Kelimon/EntwklSchRob/3D Modelle/Twisted_Hexagon_Chess_Set_680373/images/Twisted_Chess_Set_Render.JPG

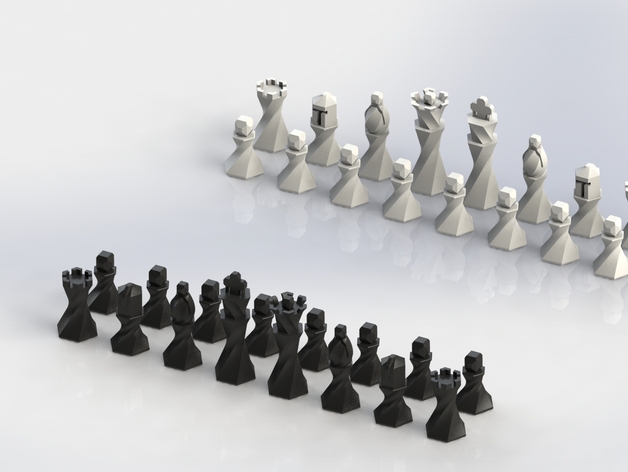
3D Modelle/Twisted_Hexagon_Chess_Set_680373/images/Twisted_Chess_Set_Render.JPG
