Kelimon/EntwklSchRob/3D Modelle/Twisted_Hexagon_Chess_Set_680373/images/Twisted_Pawn.jpg

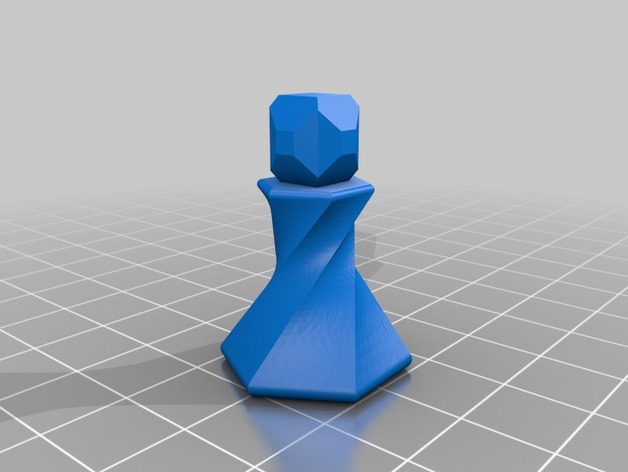
3D Modelle/Twisted_Hexagon_Chess_Set_680373/images/Twisted_Pawn.jpg
