Kelimon/EntwklSchRob/Protokolle Treffen/Notizen 28.02.2024.docx

Treffen mit Noe

Starke Zweifel an der Genauigkeit der Figurenerkennung.

Spielzug Erkennung mit Knopf.

Plausibilitätstest.

Was am meisten verändert hat.

Andere Projekte anschauen!!!!! (vor allem Du Pana)

Softwarearchitektur und Design betrachten!!!!!!!!

Nur noch 2,5 Monate!!!!!

Arbeit an Ihn schicken

25. März 10:00 Termin mit Noe und Pana zur Kamera Erkennung.

9. April 9:00 Termin mit Noe, Pana und Linus (Normaler Termin)
