Kelimon/EntwklSchRob/3D Modelle/Linearmotor Produkt Blatt.png

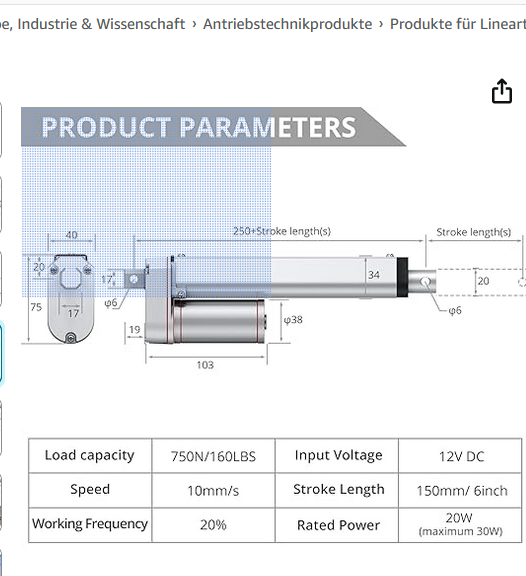
3D Modelle/Linearmotor Produkt Blatt.png
