Kelimon/EntwklSchRob/3D Modelle/Twisted_Hexagon_Chess_Set_680373/images/20150208_164236.jpg

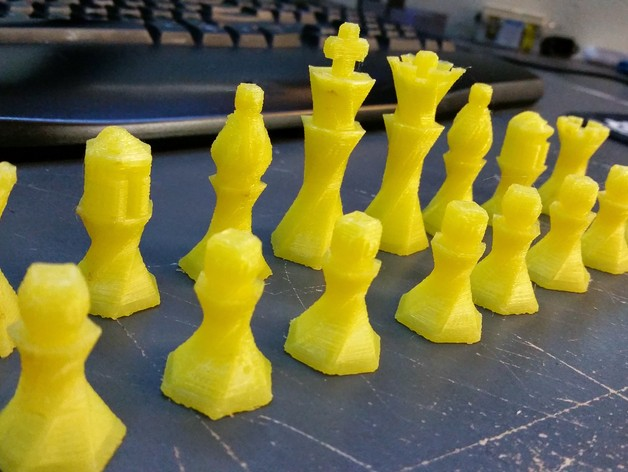
3D Modelle/Twisted_Hexagon_Chess_Set_680373/images/20150208_164236.jpg
