Kelimon/EntwklSchRob/3D Modelle/Twisted_Hexagon_Chess_Set_680373/images/20150803_194950.jpg

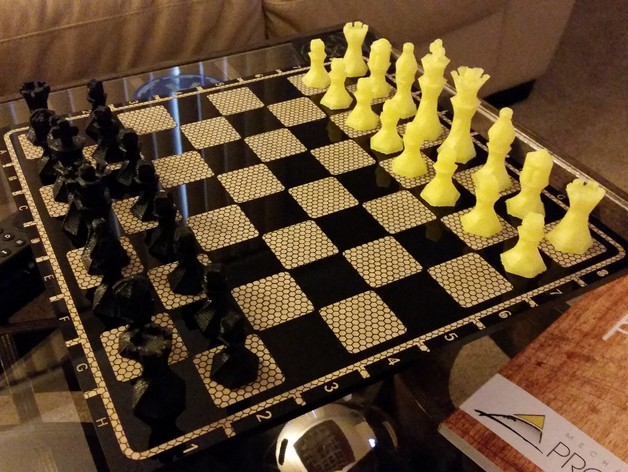
3D Modelle/Twisted_Hexagon_Chess_Set_680373/images/20150803_194950.jpg
