Kelimon/EntwklSchRob/3D Modelle/Twisted_Hexagon_Chess_Set_680373/images/Hexagon_Chess_Set_DraftSight_screen_shot.JPG

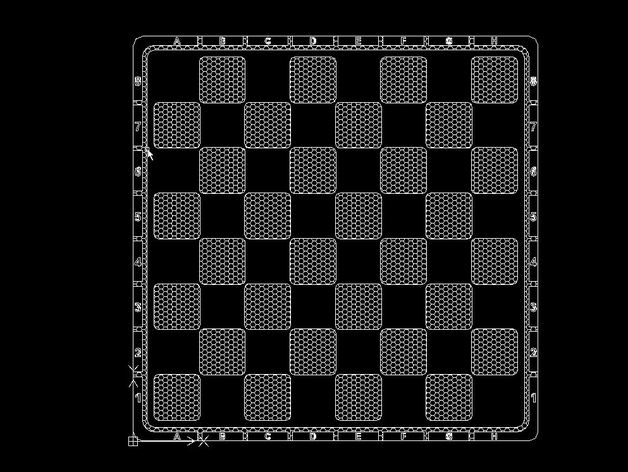
3D Modelle/Twisted_Hexagon_Chess_Set_680373/images/Hexagon_Chess_Set_DraftSight_screen_shot.JPG
