Kelimon/EntwklSchRob/3D Modelle/Twisted_Hexagon_Chess_Set_680373/images/Twisted_Chess_set_Render_-_close_up.JPG

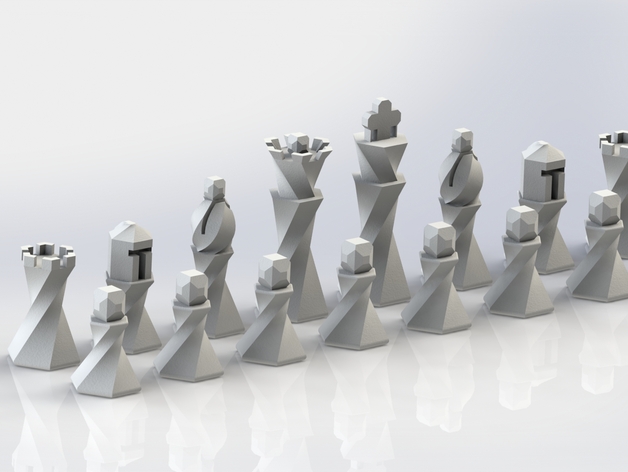
3D Modelle/Twisted_Hexagon_Chess_Set_680373/images/Twisted_Chess_set_Render_-_close_up.JPG
