Kelimon/EntwklSchRob/Bilder Studienarbeit/Bild Drehmechanismus.jpg

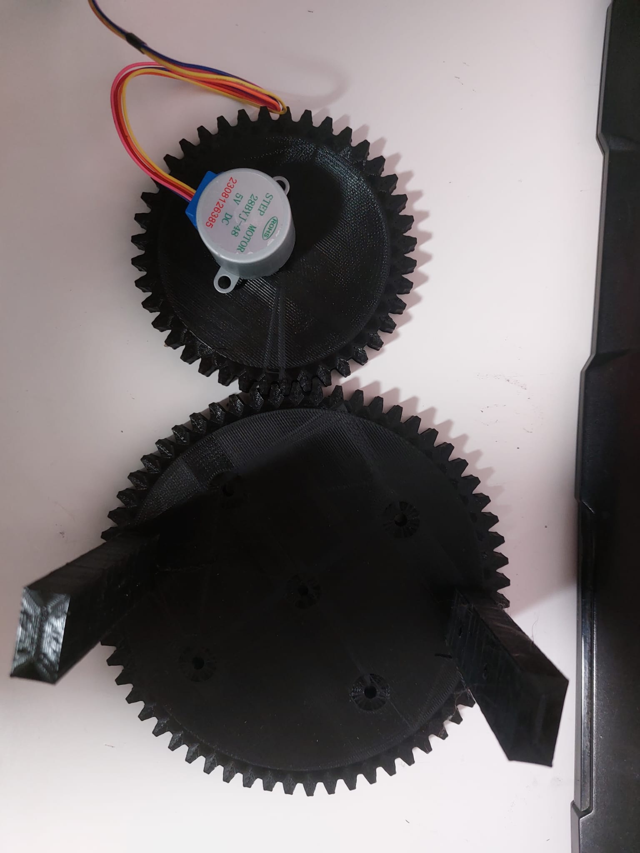
Bilder Studienarbeit/Bild Drehmechanismus.jpg
