Kelimon/EntwklSchRob/Bilder Studienarbeit/Bild Roboterarm mit Markierung.png

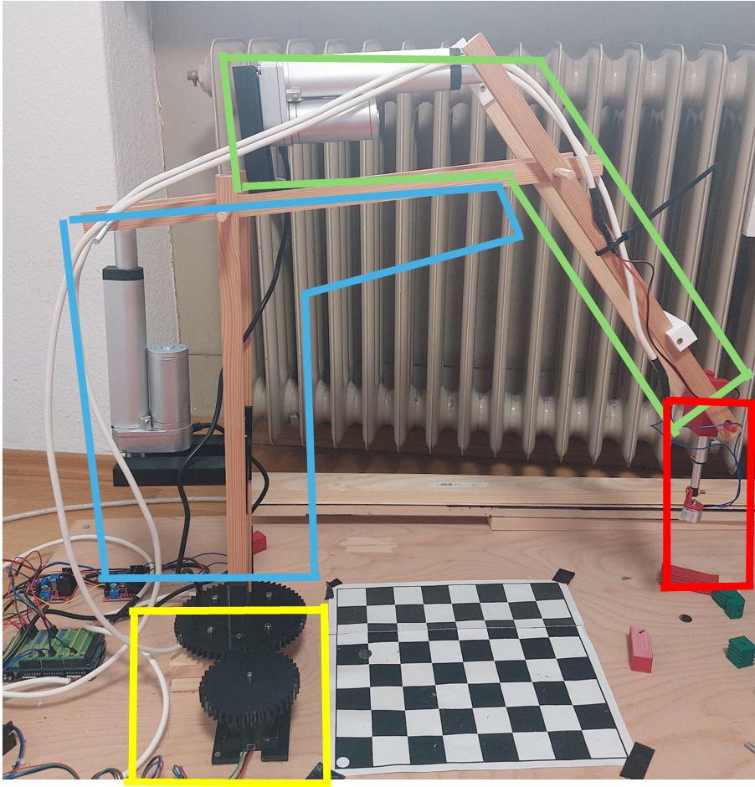
Bilder Studienarbeit/Bild Roboterarm mit Markierung.png
