Kelimon/EntwklSchRob/Bilder Studienarbeit/Fehler Figurenaufnahme.jpg

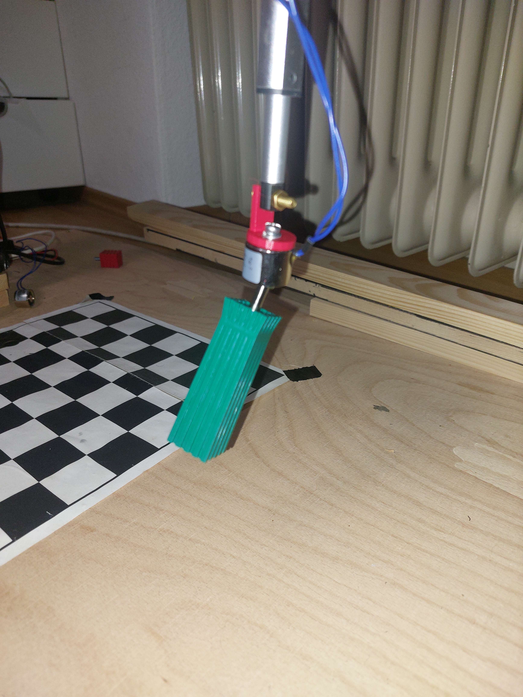
Bilder Studienarbeit/Fehler Figurenaufnahme.jpg
