Kelimon/EntwklSchRob/Bilder Studienarbeit/Figuren Fertig2.jpg

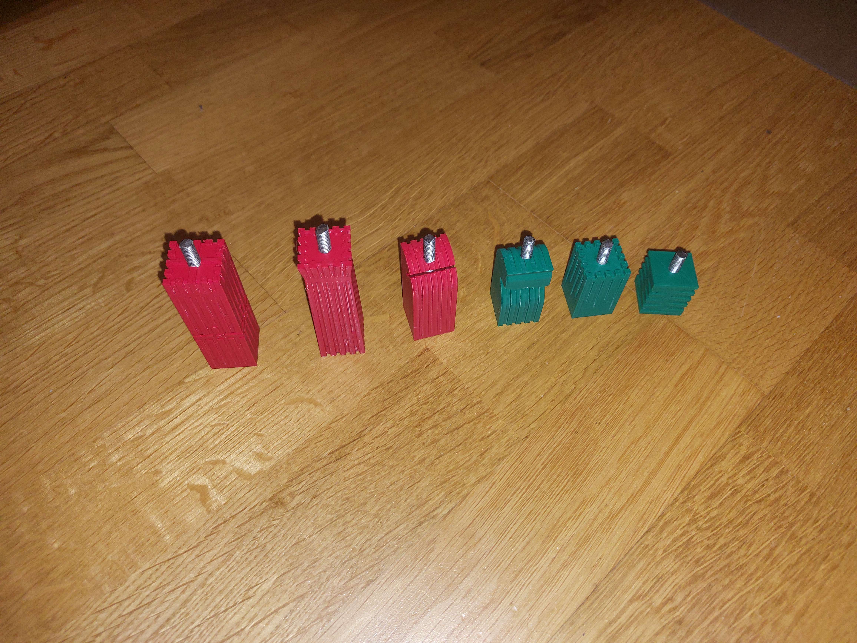
Bilder Studienarbeit/Figuren Fertig2.jpg
