Kelimon/EntwklSchRob/Bilder Studienarbeit/Figuren fertig.jpg

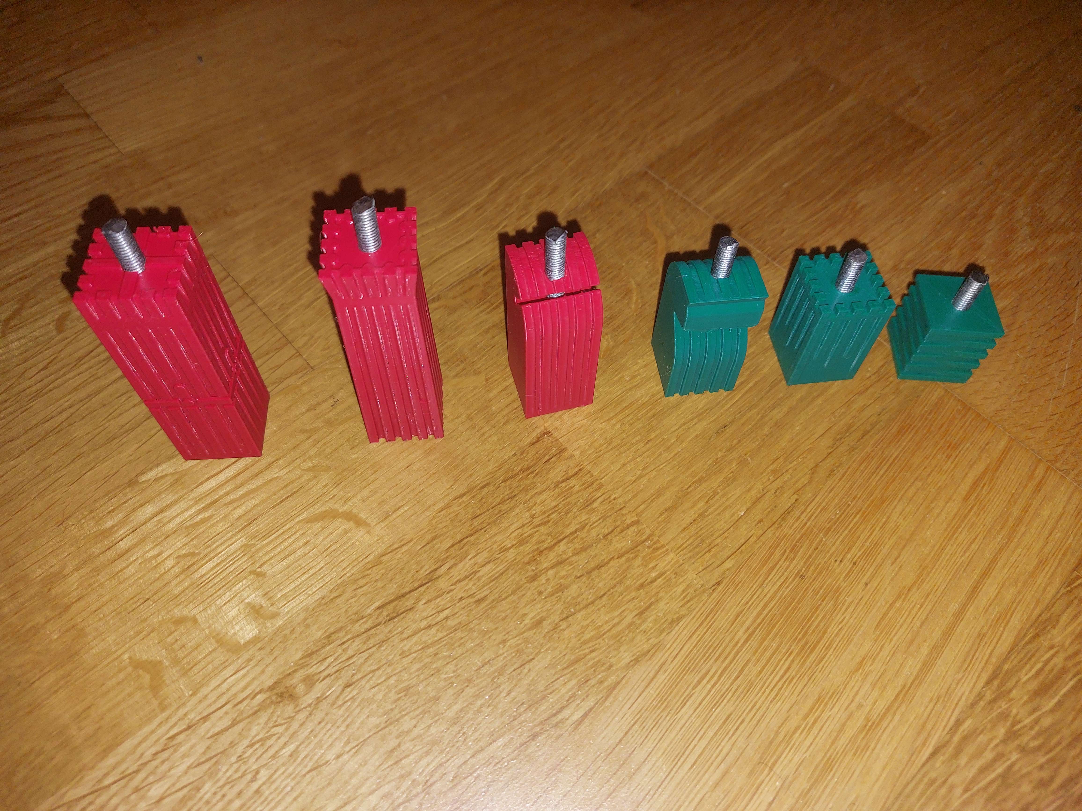
Bilder Studienarbeit/Figuren fertig.jpg
