Kelimon/EntwklSchRob/Bilder Studienarbeit/Gesamtarm2.jpg

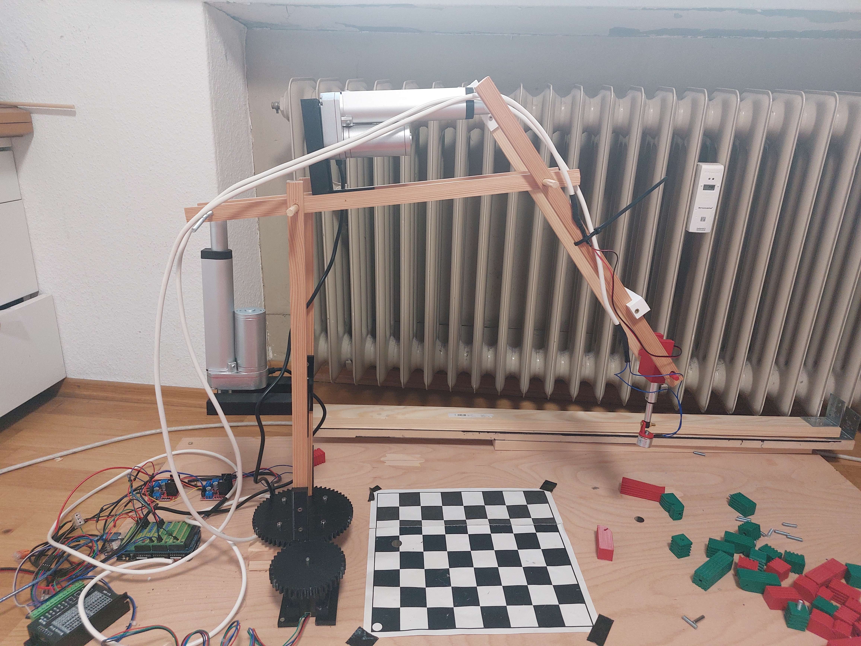
Bilder Studienarbeit/Gesamtarm2.jpg
