Kelimon/EntwklSchRob/Bilder Studienarbeit/Gesamtarm.jpg

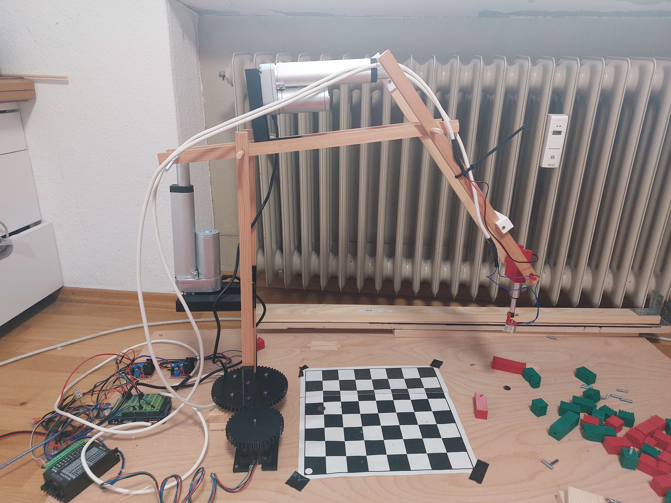
Bilder Studienarbeit/Gesamtarm.jpg
