Kelimon/EntwklSchRob/Bilder Studienarbeit/Halterung Linearmotor.png

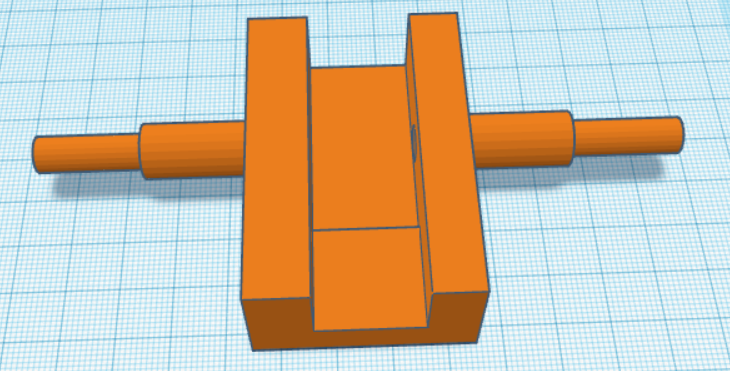
Bilder Studienarbeit/Halterung Linearmotor.png
