Kelimon/EntwklSchRob/Bilder Studienarbeit/Schaltplan.jpg

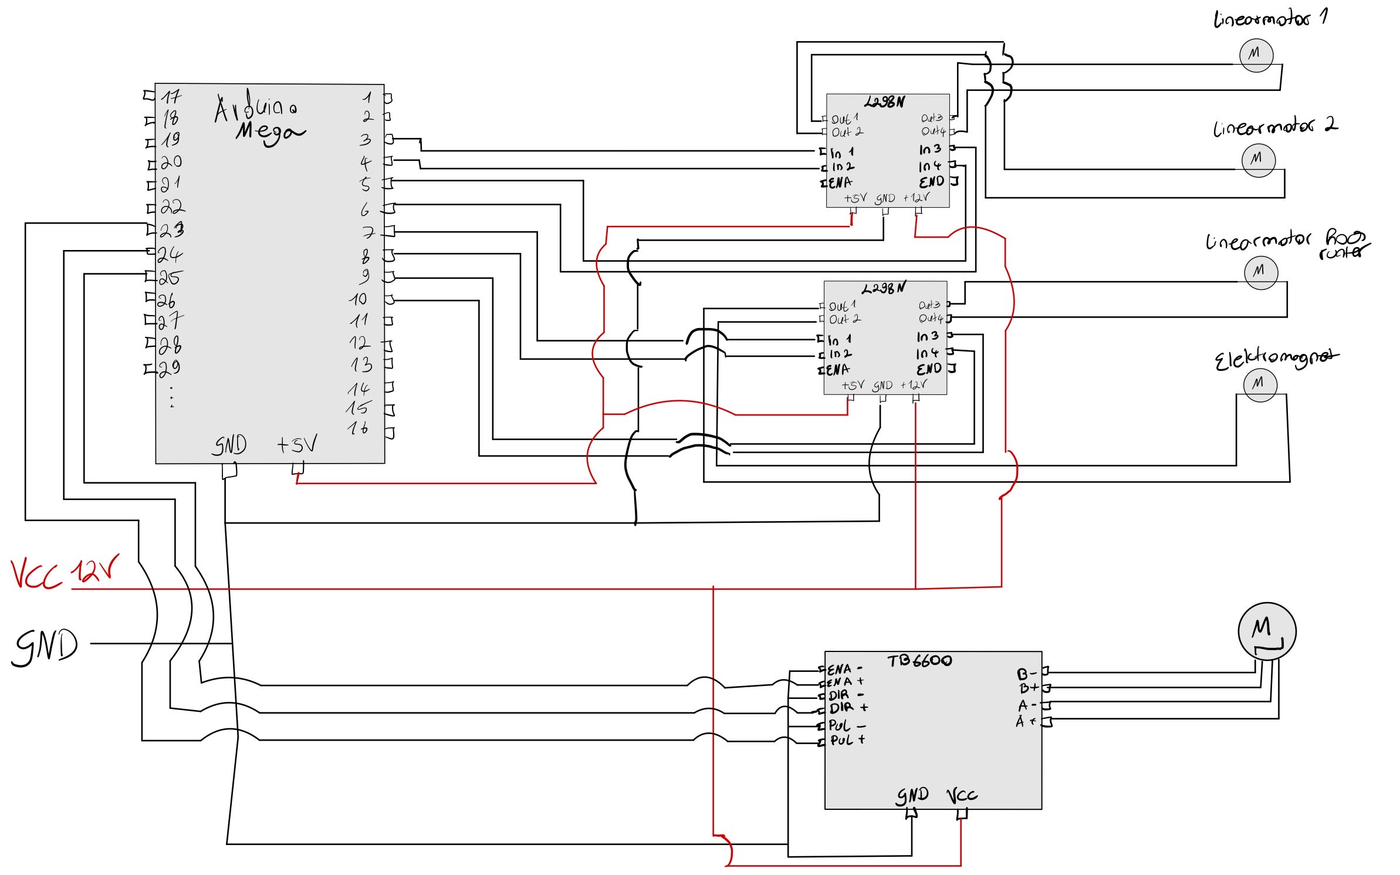
Bilder Studienarbeit/Schaltplan.jpg
