Kelimon/EntwklSchRob/Bilder Studienarbeit/Screenshot 2024-02-23 163539.png

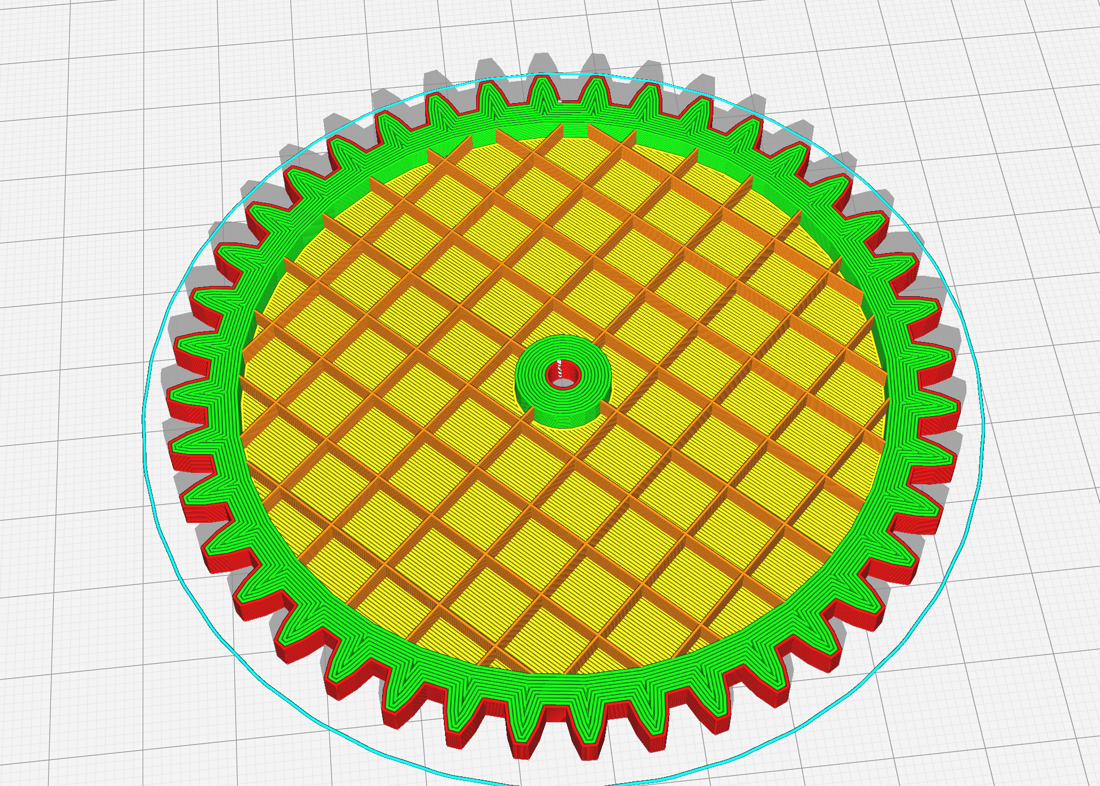
Bilder Studienarbeit/Screenshot 2024-02-23 163539.png
