Kelimon/EntwklSchRob/Bilder Studienarbeit/Stiftest1.jpg

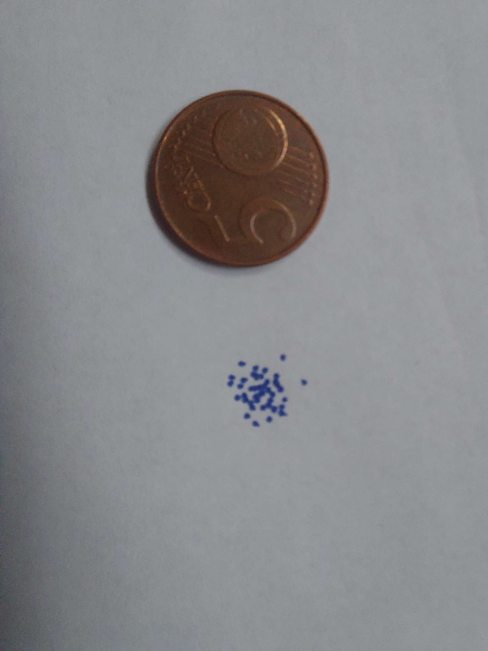
Bilder Studienarbeit/Stiftest1.jpg
