Kelimon/EntwklSchRob/Bilder Studienarbeit/Stiftest2.jpg

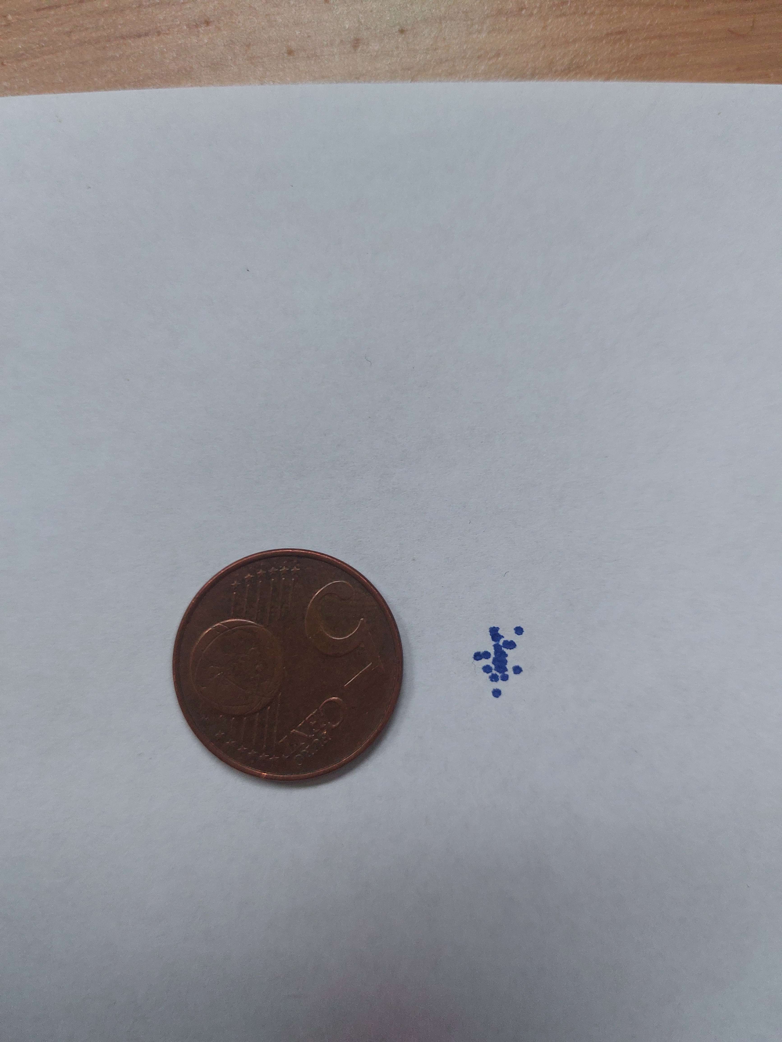
Bilder Studienarbeit/Stiftest2.jpg
