Kelimon/EntwklSchRob/Bilder Studienarbeit/Stiftest3.jpg

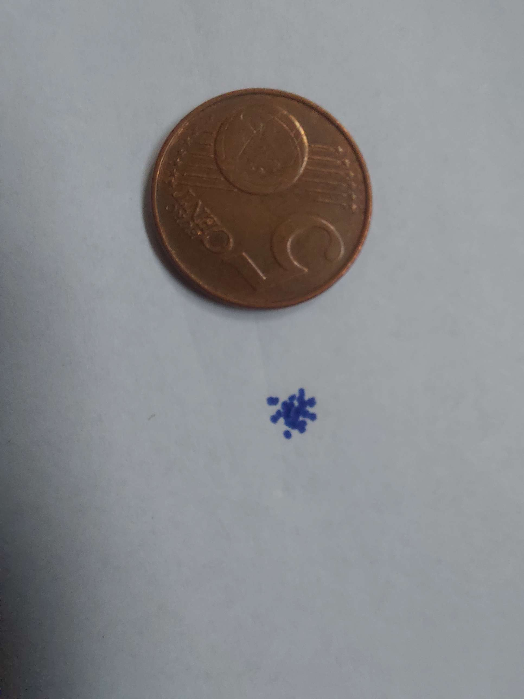
Bilder Studienarbeit/Stiftest3.jpg
