Kelimon/EntwklSchRob/Bilder und Videos Allgemein/20231207_153450.jpg

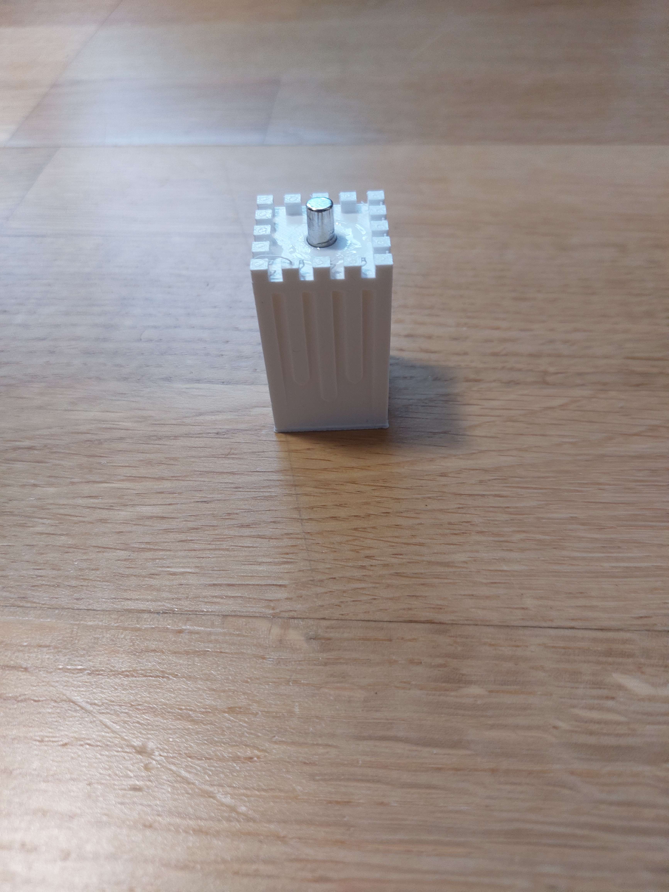
Bilder und Videos Allgemein/20231207_153450.jpg
