Kelimon/EntwklSchRob/Bilder und Videos Allgemein/20231207_153452.jpg

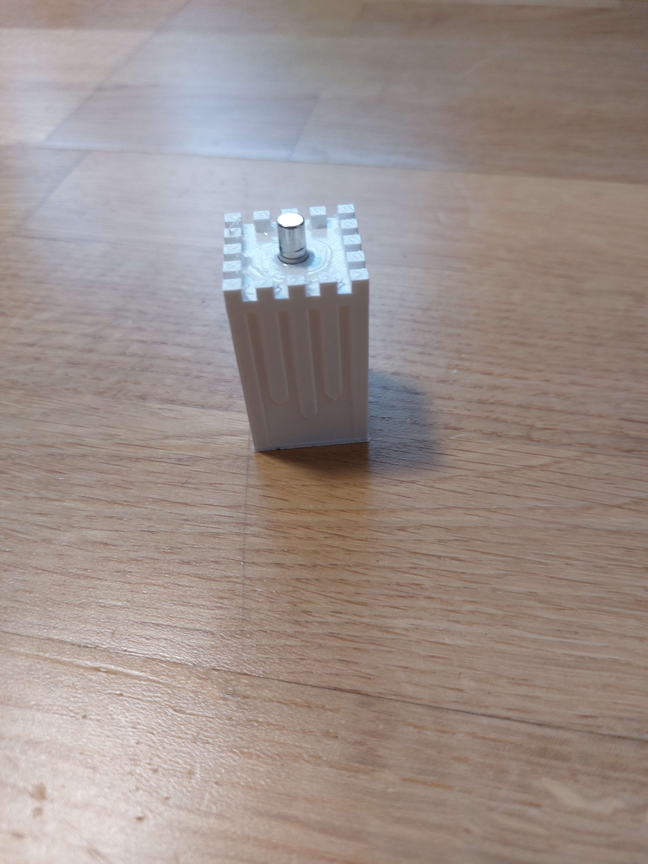
Bilder und Videos Allgemein/20231207_153452.jpg
