Kelimon/EntwklSchRob/Bilder und Videos Allgemein/20231207_153454.jpg

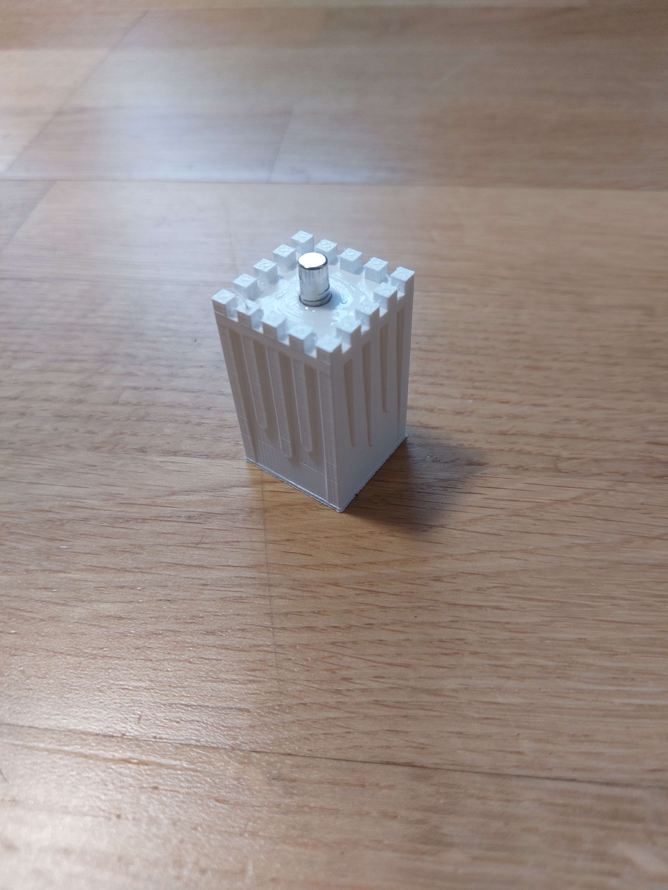
Bilder und Videos Allgemein/20231207_153454.jpg
