Kelimon/EntwklSchRob/Bilder und Videos Allgemein/20231207_153458.jpg

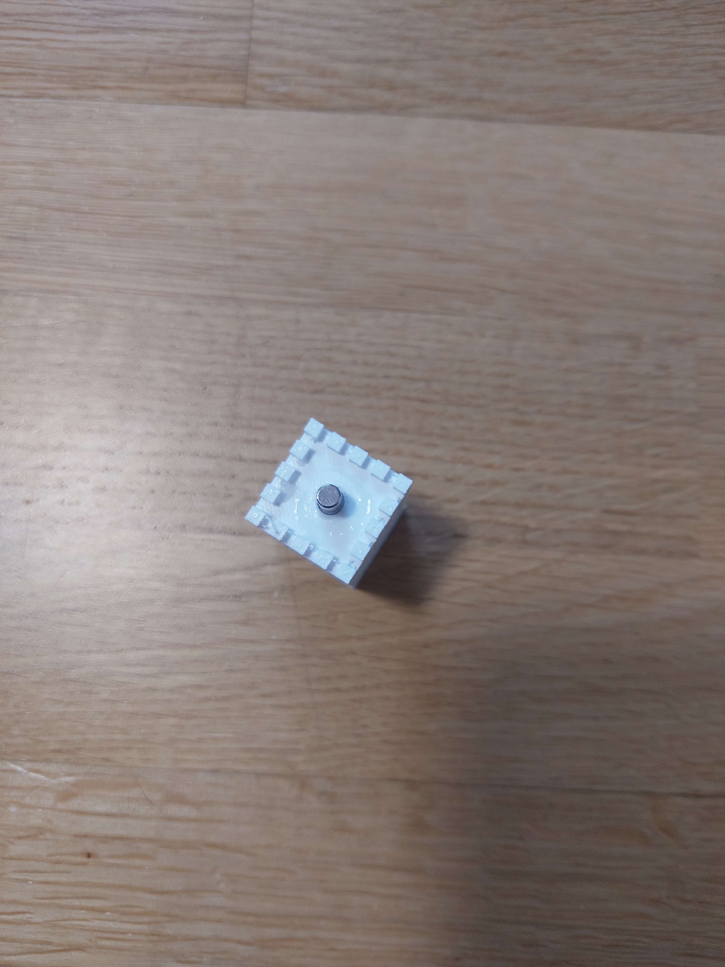
Bilder und Videos Allgemein/20231207_153458.jpg
