Kelimon/EntwklSchRob/Bilder und Videos Allgemein/20231207_153509.jpg

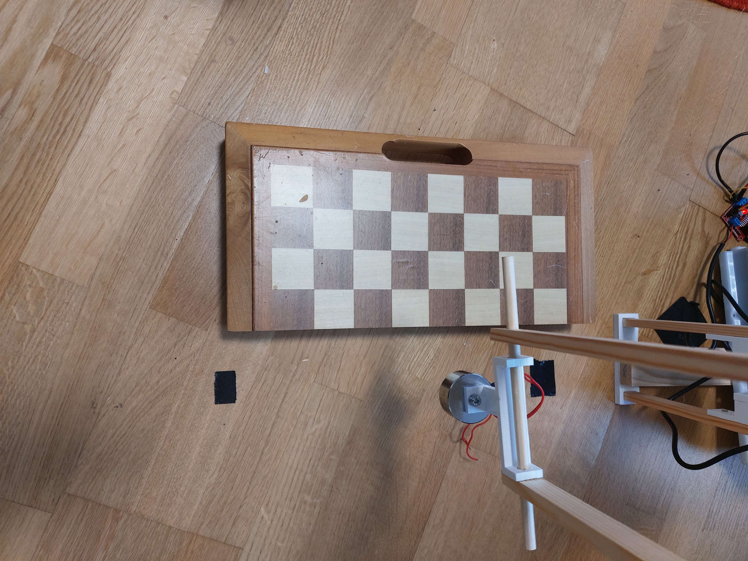
Bilder und Videos Allgemein/20231207_153509.jpg
