Kelimon/EntwklSchRob/Bilder und Videos Allgemein/20231207_153511.jpg

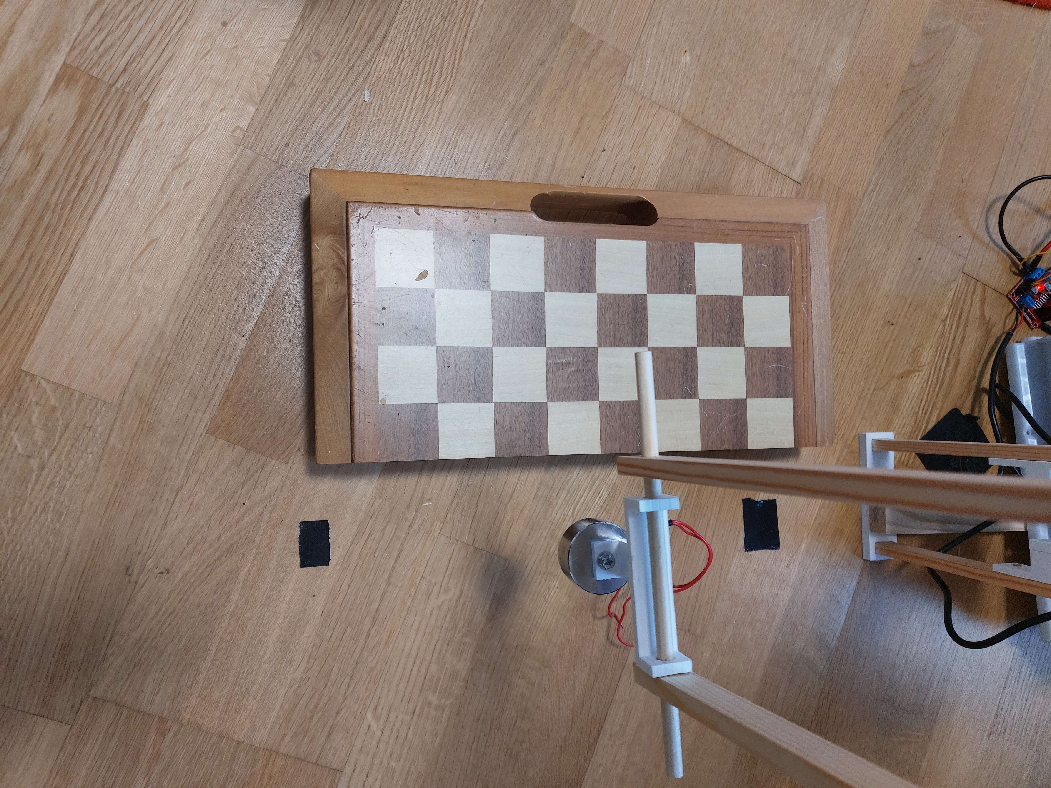
Bilder und Videos Allgemein/20231207_153511.jpg
