Kelimon/EntwklSchRob/Bilder und Videos Allgemein/20231207_153522.jpg

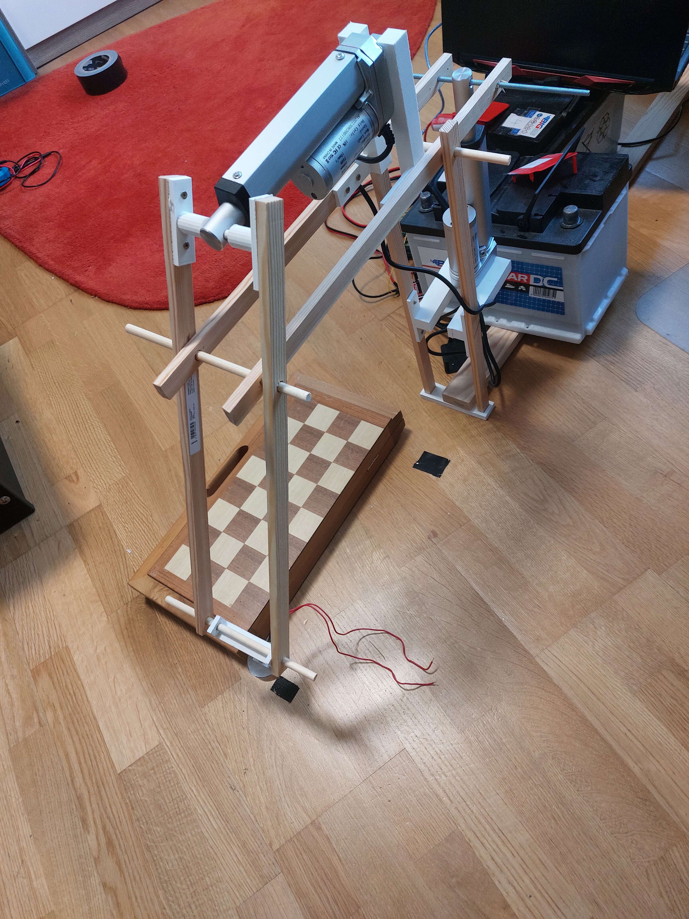
Bilder und Videos Allgemein/20231207_153522.jpg
