Kelimon/EntwklSchRob/Bilder und Videos Allgemein/20231207_153542.jpg

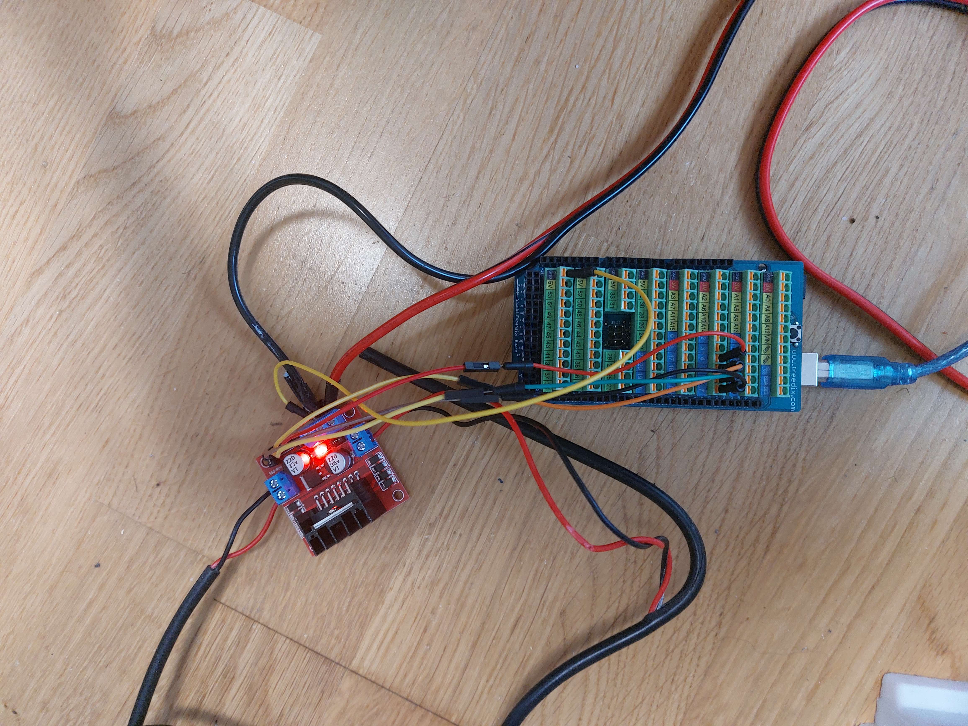
Bilder und Videos Allgemein/20231207_153542.jpg
