Kelimon/EntwklSchRob/Bilder und Videos Allgemein/20231207_153546.jpg

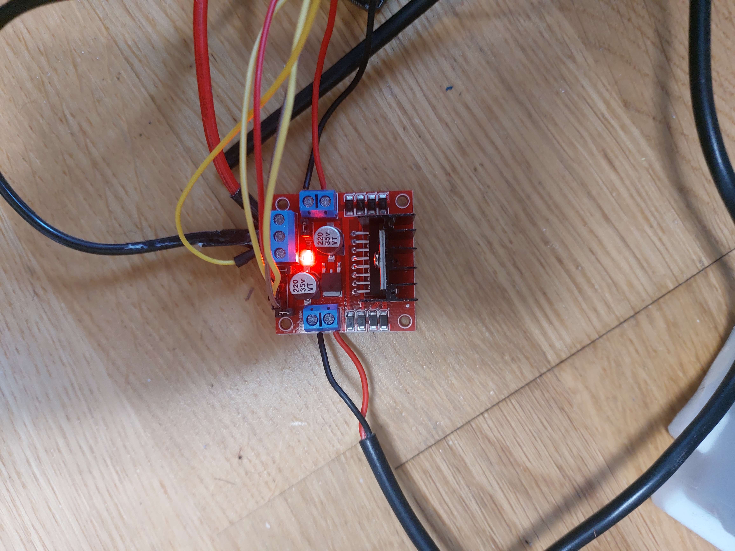
Bilder und Videos Allgemein/20231207_153546.jpg
