Kelimon/EntwklSchRob/Bilder und Videos Allgemein/20231207_153550.jpg

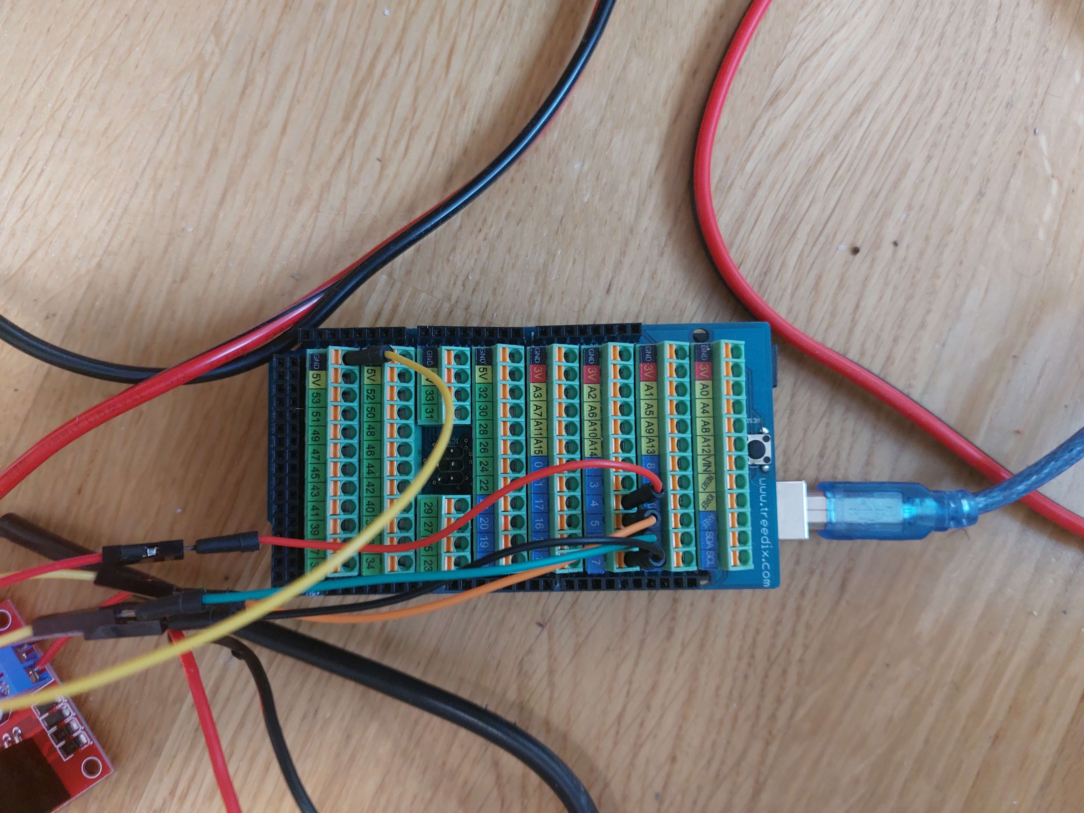
Bilder und Videos Allgemein/20231207_153550.jpg
