Kelimon/EntwklSchRob/Bilder und Videos Allgemein/20231207_153600.jpg

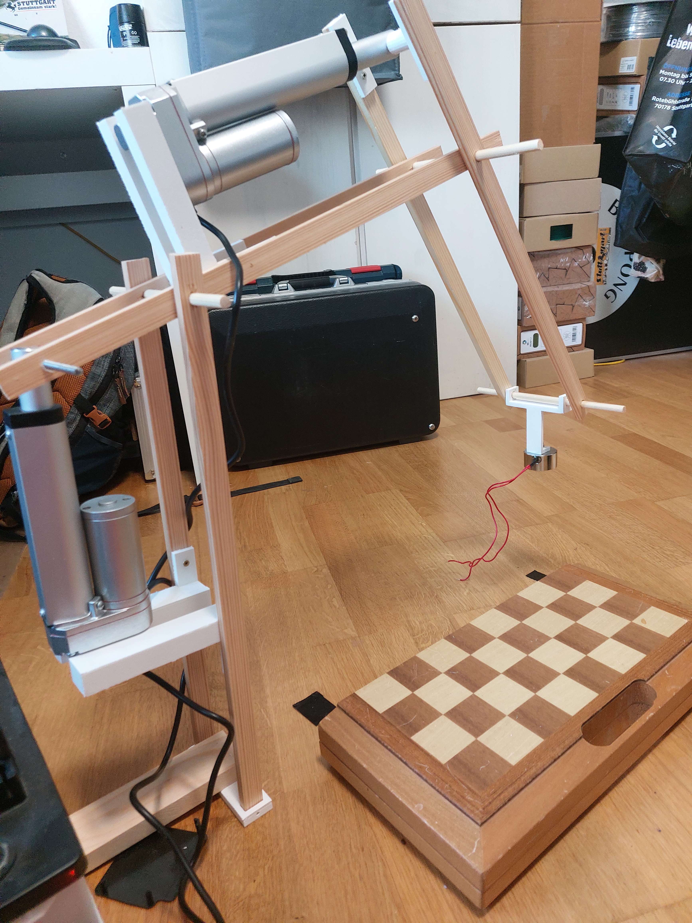
Bilder und Videos Allgemein/20231207_153600.jpg
