Kelimon/EntwklSchRob/Bilder und Videos Allgemein/20231207_154315.jpg

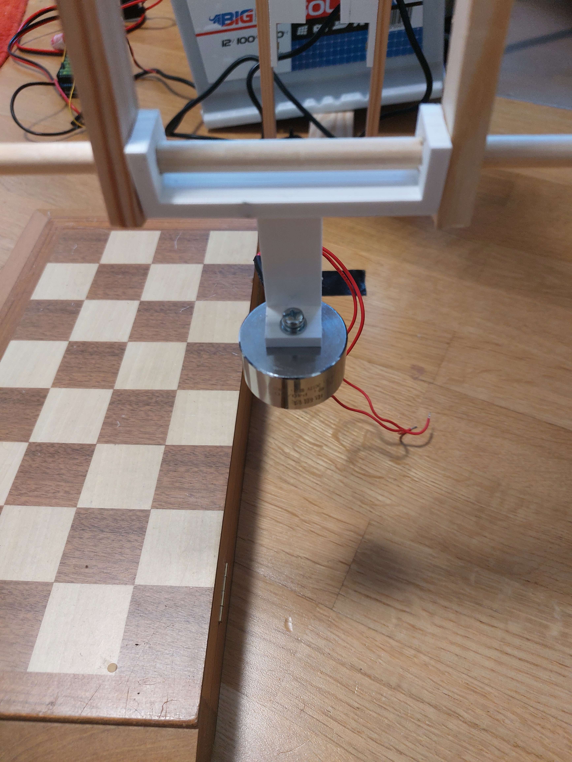
Bilder und Videos Allgemein/20231207_154315.jpg
