Kelimon/EntwklSchRob/Bilder und Videos Allgemein/20240416_121637.jpg

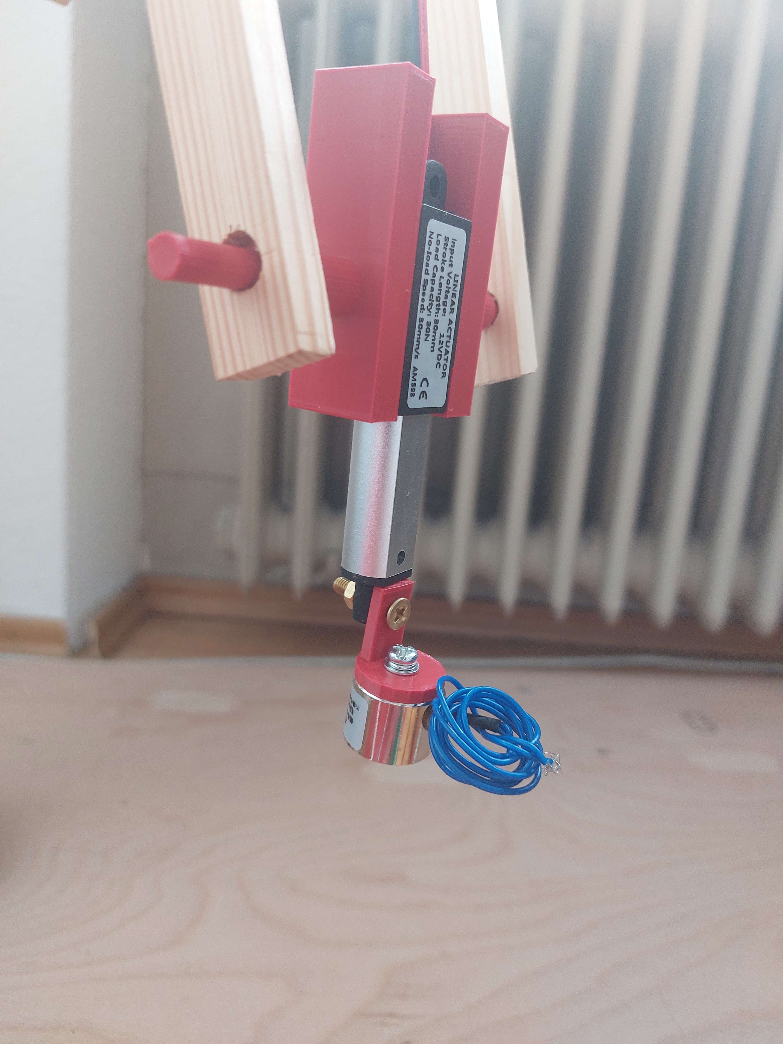
Bilder und Videos Allgemein/20240416_121637.jpg
