Kelimon/EntwklSchRob/Bilder und Videos Allgemein/20240416_121639.jpg

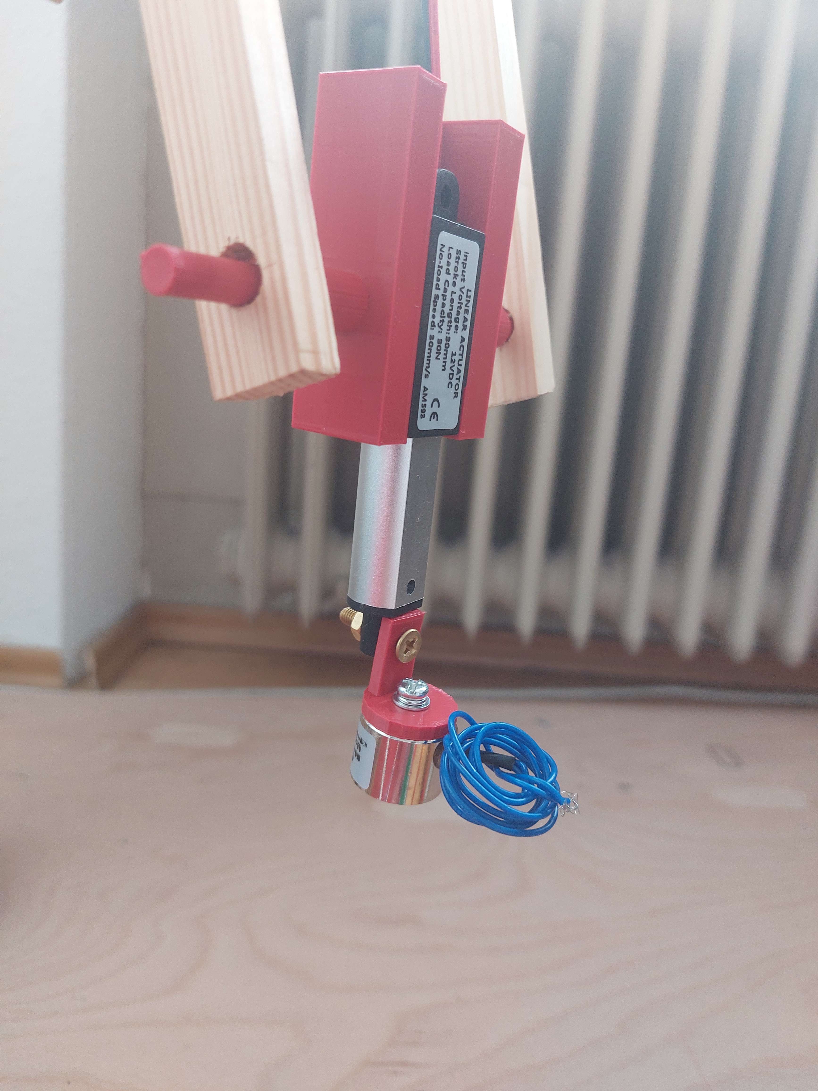
Bilder und Videos Allgemein/20240416_121639.jpg
