Kelimon/EntwklSchRob/Bilder und Videos Allgemein/20240416_122353.jpg

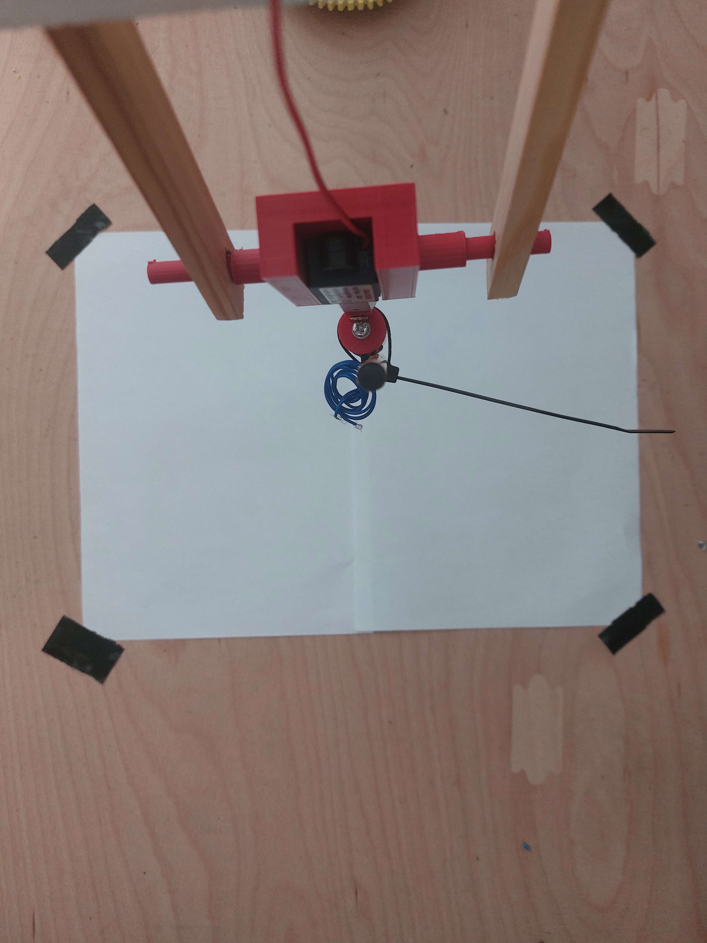
Bilder und Videos Allgemein/20240416_122353.jpg
