Kelimon/EntwklSchRob/Bilder und Videos Allgemein/20240416_122356.jpg

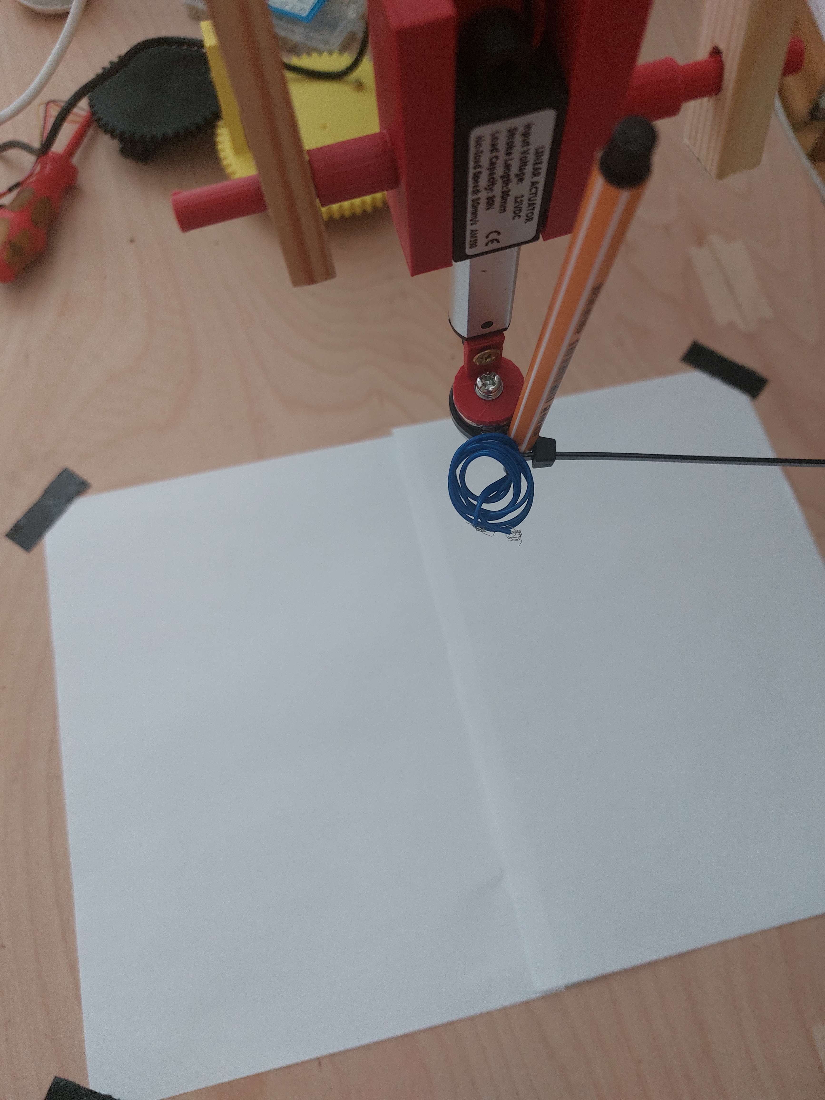
Bilder und Videos Allgemein/20240416_122356.jpg
