Kelimon/EntwklSchRob/Bilder und Videos Allgemein/20240416_122358.jpg

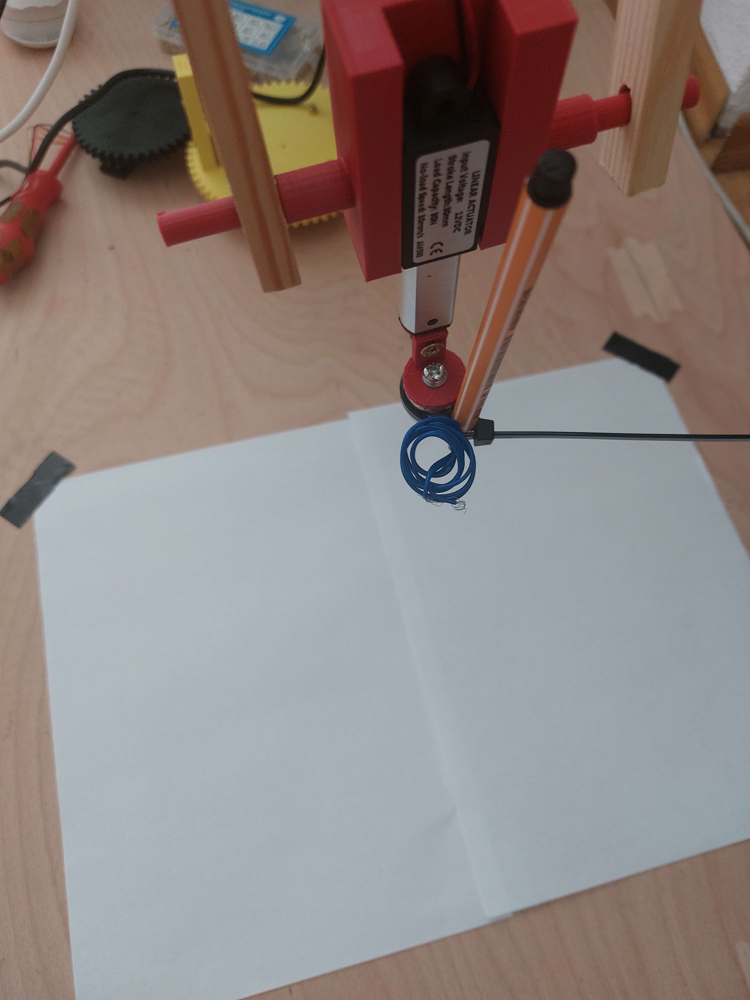
Bilder und Videos Allgemein/20240416_122358.jpg
