Kelimon/EntwklSchRob/Bilder und Videos Allgemein/20240416_122404.jpg

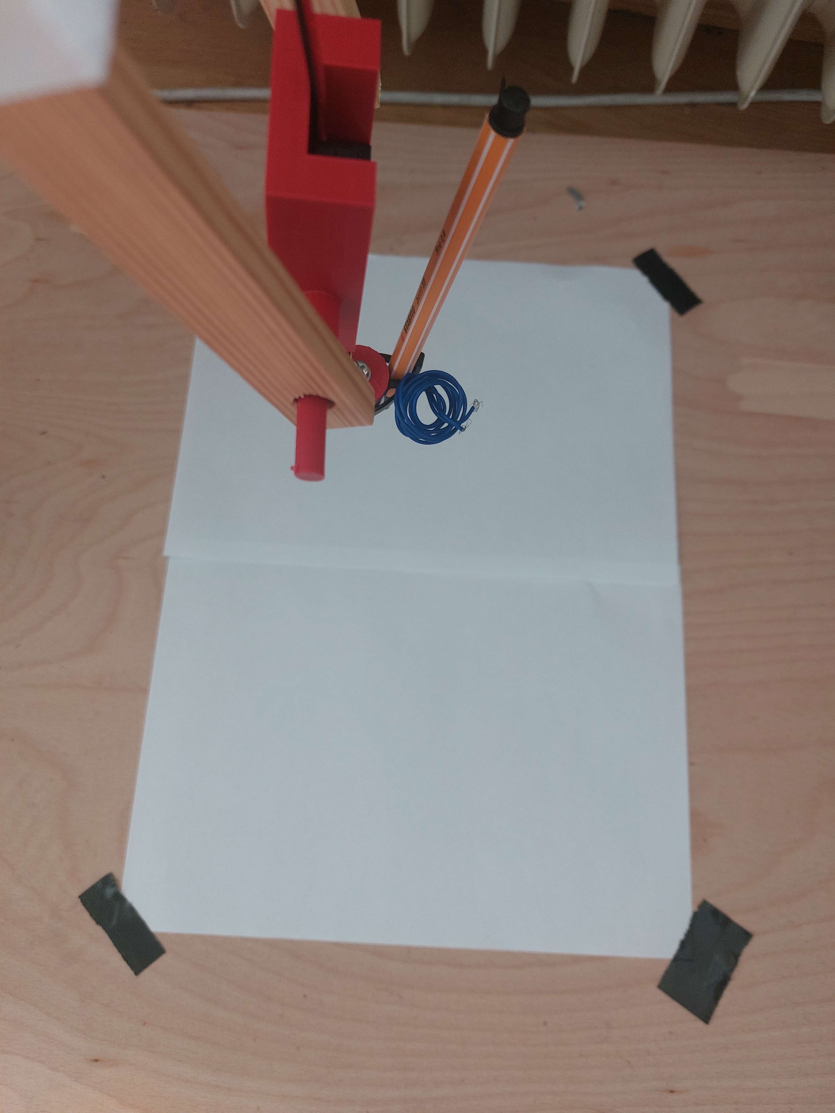
Bilder und Videos Allgemein/20240416_122404.jpg
