Kelimon/EntwklSchRob/Bilder und Videos Allgemein/20240417_084811.jpg

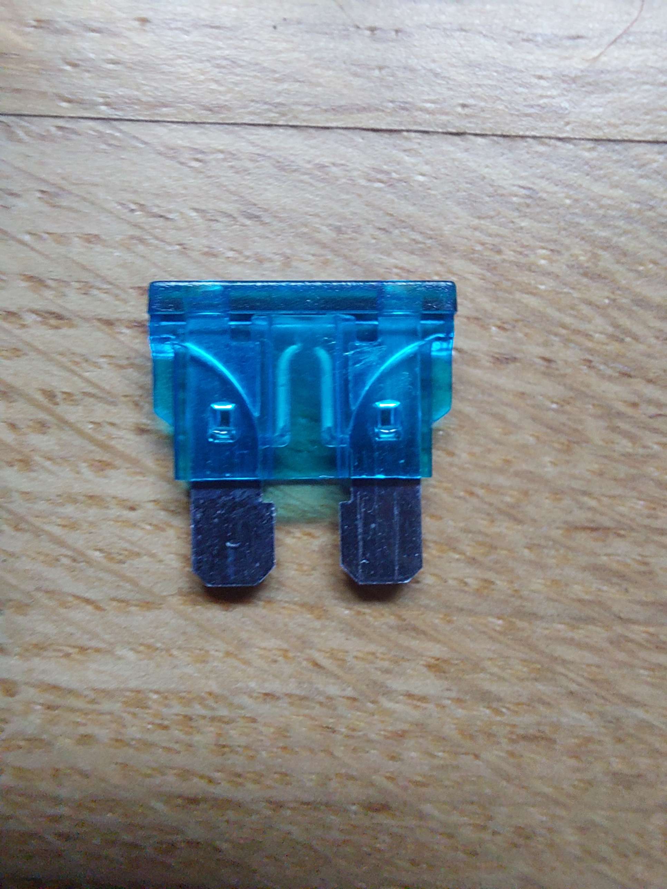
Bilder und Videos Allgemein/20240417_084811.jpg
