Kelimon/EntwklSchRob/Bilderkennung/images/chessboard2.1.jpg

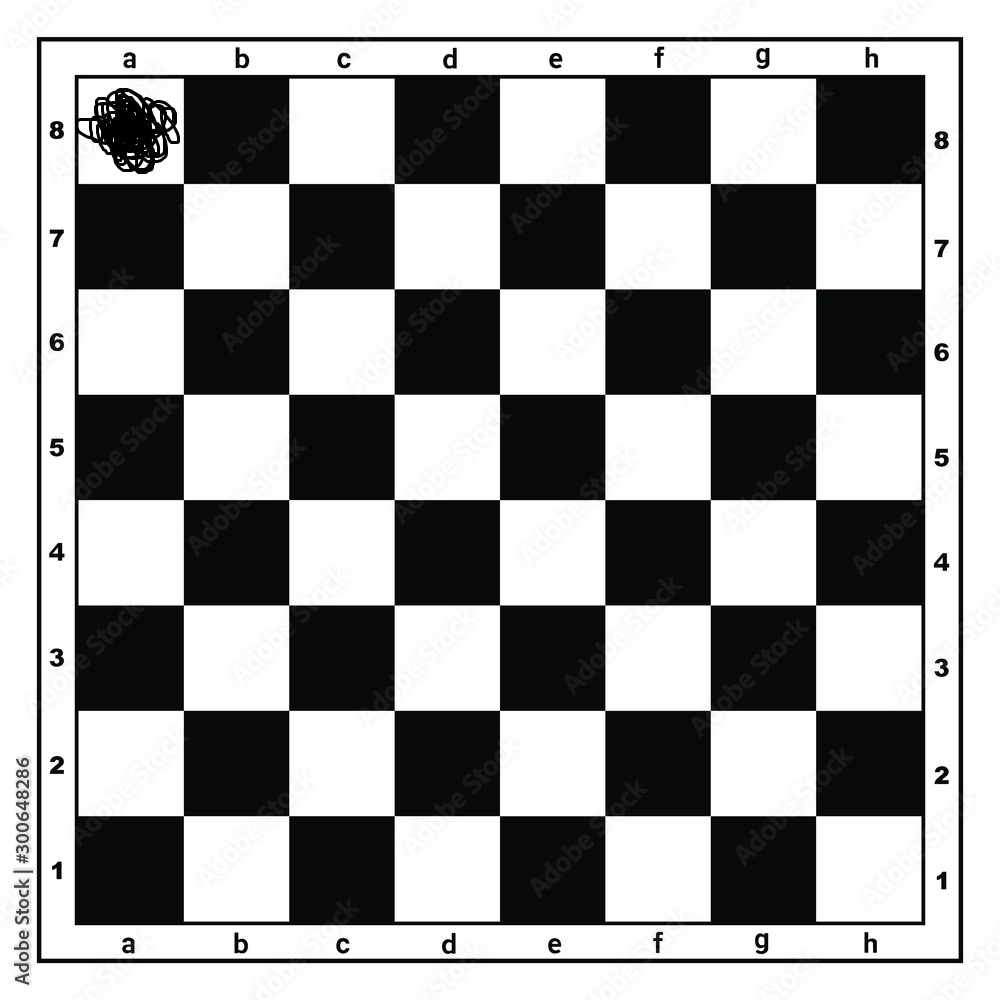
Bilderkennung/images/chessboard2.1.jpg
