Kelimon/EntwklSchRob/Bilderkennung/images/chessboard3.1.5.jpg

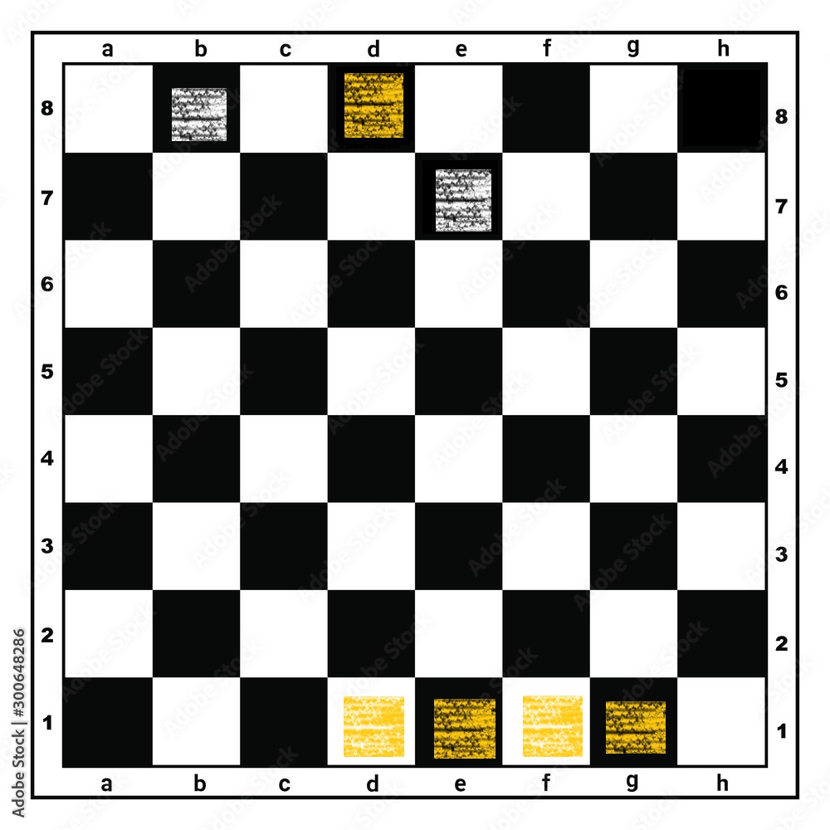
Bilderkennung/images/chessboard3.1.5.jpg
