Kelimon/EntwklSchRob/3D Modelle/läufer.stl

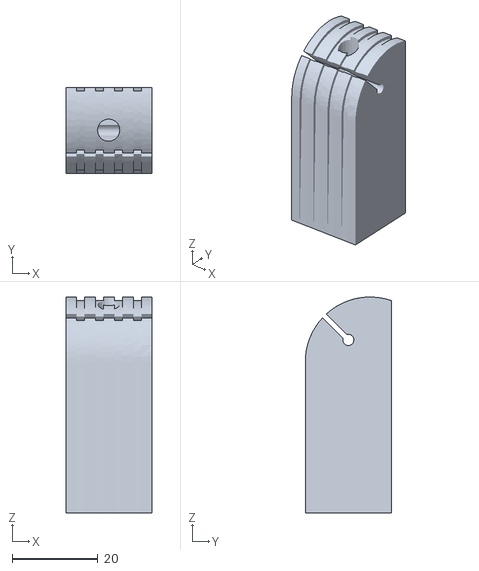
[picture p66: CAD file, 2024-06-05]
3D Modelle/läufer.stl
20.2 x 20.2 x 50.4
