Kelimon/EntwklSchRob/3D Modelle/pieces-d-echecs-minimalistes/02-Queen-V2.stl

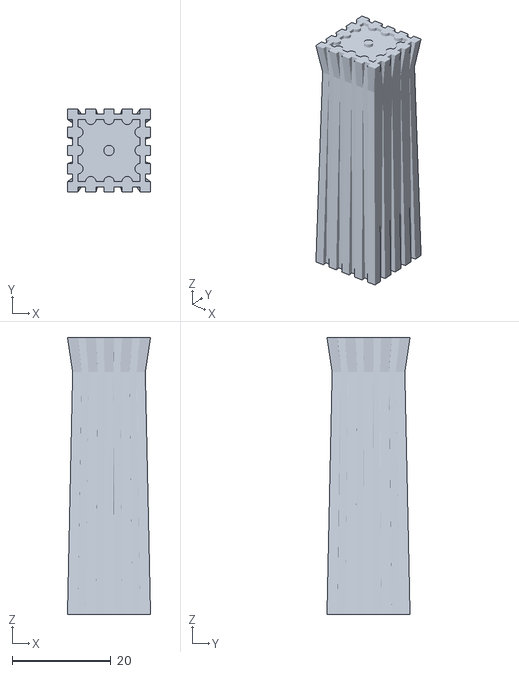
[picture p67: CAD file, 2024-06-05]
3D Modelle/pieces-d-echecs-minimalistes/02-Queen-V2.stl
16.8 x 16.8 x 56.0
