Kelimon/EntwklSchRob/3D Modelle/Roboter/Abstandshalterungen(Horizontal)/Abstandshalterung unten und vorne.stl

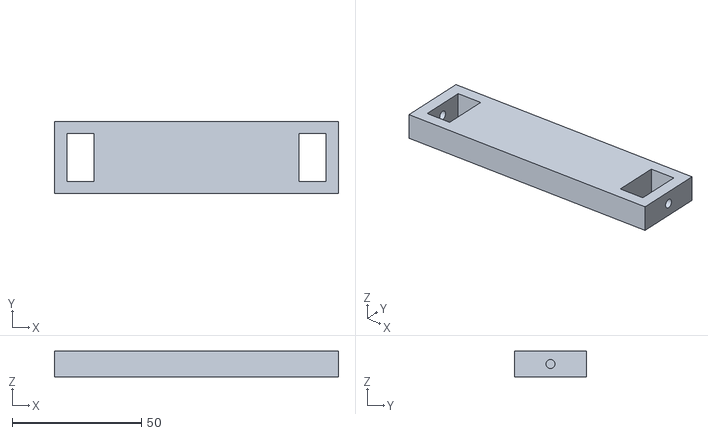
[picture p68: CAD file, 2023-11-29]
3D Modelle/Roboter/Abstandshalterungen(Horizontal)/Abstandshalterung unten und vorne.stl
110.0 x 28.0 x 10.0
