Kelimon/EntwklSchRob/3D Modelle/Roboter/Drehmechanismus/V3/Zahnrad mit Halterung V3.stl

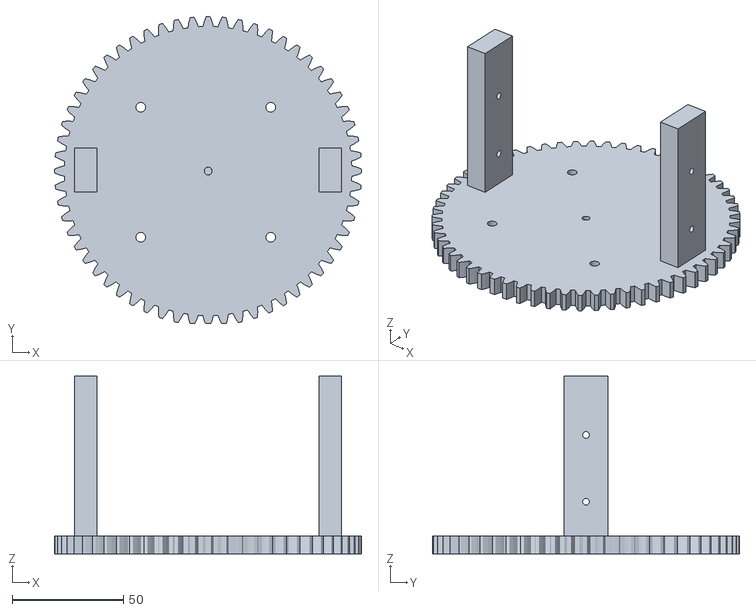
[picture p69: CAD file, 2024-03-25]
3D Modelle/Roboter/Drehmechanismus/V3/Zahnrad mit Halterung V3.stl
138.0 x 138.0 x 80.0
