Kelimon/EntwklSchRob/3D Modelle/Roboter/Drehmechanismus/Winkel Drehung.stl

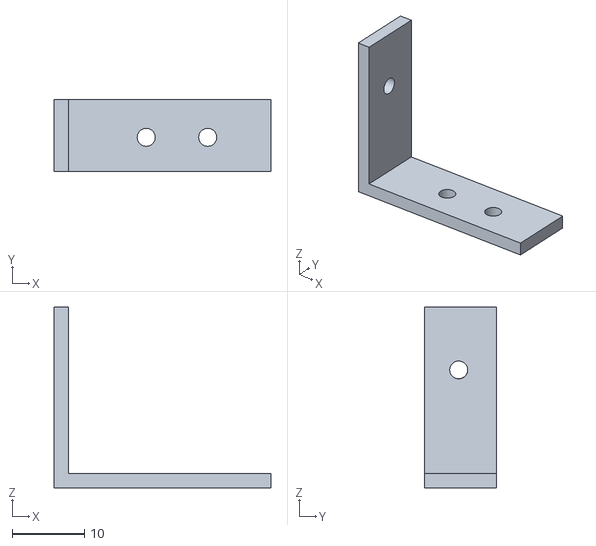
[picture p70: CAD file, 2024-02-13]
3D Modelle/Roboter/Drehmechanismus/Winkel Drehung.stl
30.0 x 10.0 x 25.0
