Kelimon/EntwklSchRob/3D Modelle/Roboter/Erster Linearmotor/Fantastic Bojo-Wolt(3).stl

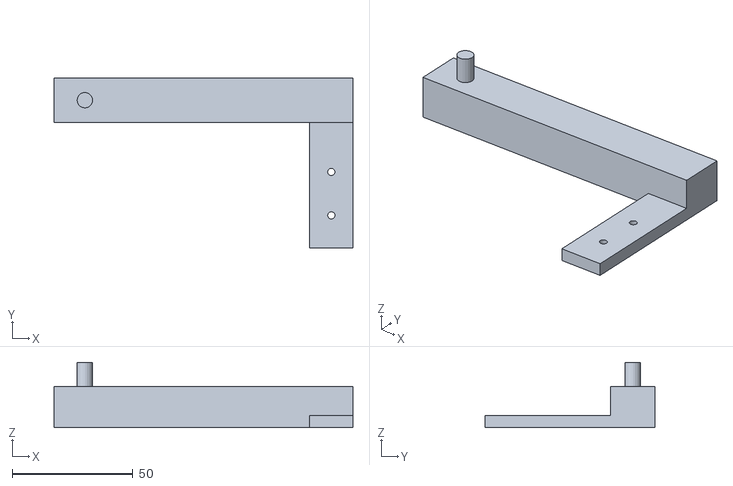
[picture p71: CAD file, 2024-06-01]
3D Modelle/Roboter/Erster Linearmotor/Fantastic Bojo-Wolt(3).stl
124.0 x 70.4 x 27.0
