Kelimon/EntwklSchRob/3D Modelle/Roboter/Linearmotor hochrunter/Halterung Linearmotor v2.stl

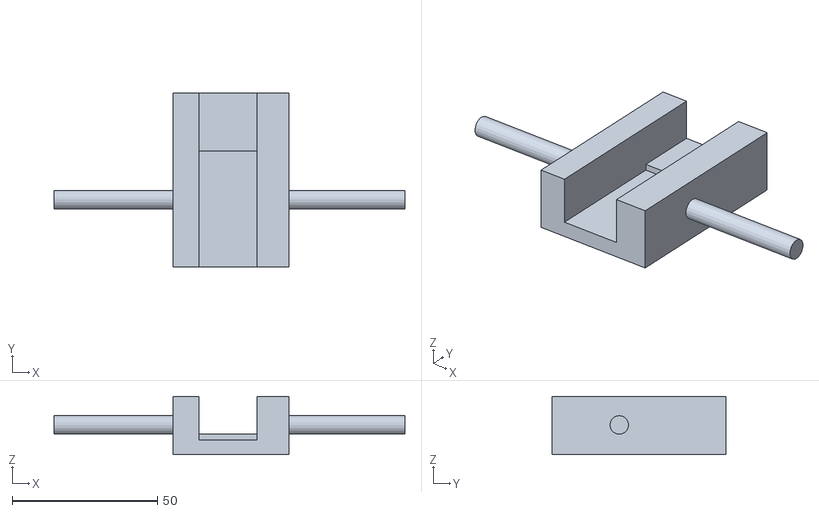
[picture p72: CAD file, 2024-05-07]
3D Modelle/Roboter/Linearmotor hochrunter/Halterung Linearmotor v2.stl
121.0 x 60.0 x 20.0
