Kelimon/EntwklSchRob/3D Modelle/Roboter/Magnethalterung/Magnethalterung.stl

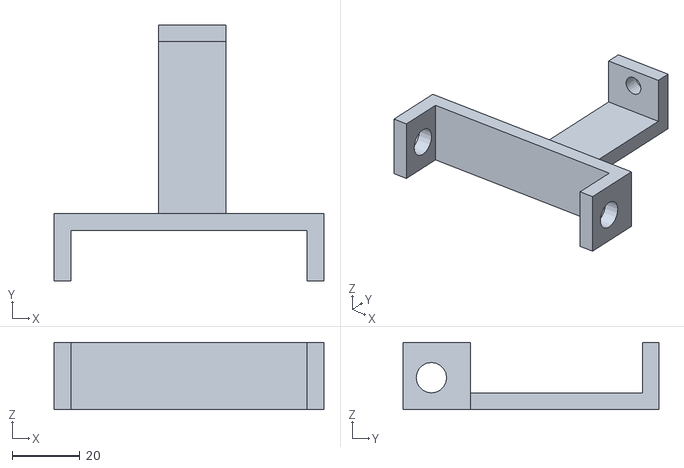
[picture p73: CAD file, 2023-11-29]
3D Modelle/Roboter/Magnethalterung/Magnethalterung.stl
80.0 x 76.0 x 20.0
