Kelimon/EntwklSchRob/3D Modelle/Twisted_Hexagon_Chess_Set_680373/files/Twisted_Rook.STL

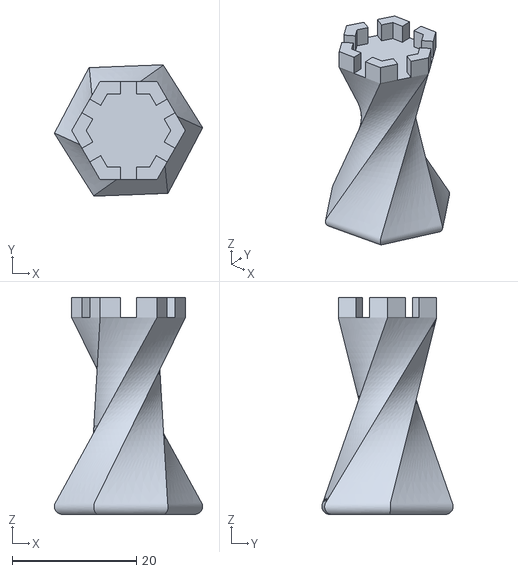
[picture p74: CAD file, 2023-10-30]
3D Modelle/Twisted_Hexagon_Chess_Set_680373/files/Twisted_Rook.STL
23.9 x 21.2 x 35.0
