Kelimon/EntwklSchRob/3D Modelle/pieces-d-echecs-minimalistes/04-Knight-V2.STL

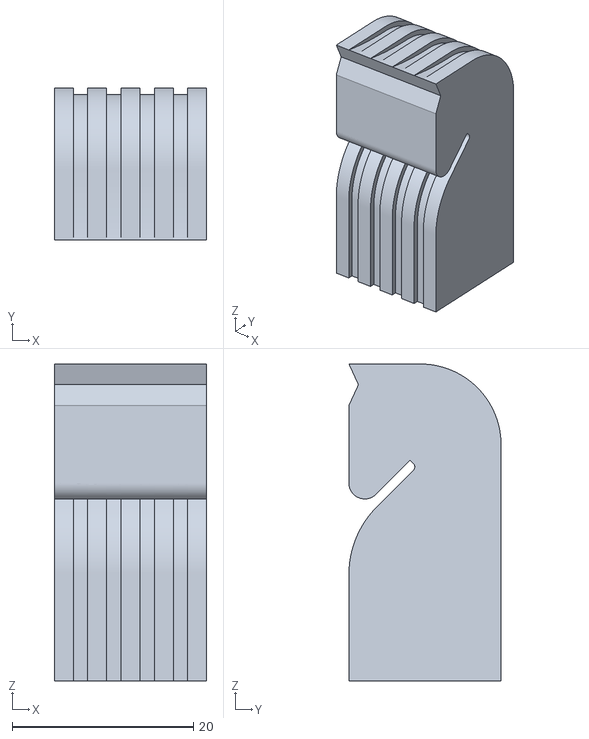
[picture p75: CAD file, 2023-10-30]
3D Modelle/pieces-d-echecs-minimalistes/04-Knight-V2.STL
16.8 x 16.8 x 35.0
