Kelimon/EntwklSchRob/3D Modelle/Roboter/Abstandshalterungen(Horizontal)/Abstandshalterung oben (Linus).stl

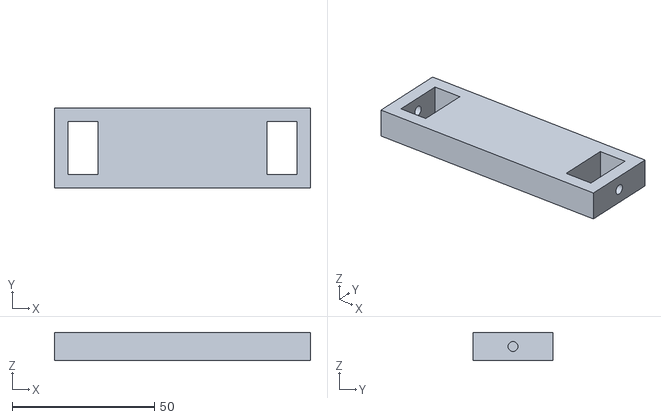
[picture p76: CAD file, 2023-11-29]
3D Modelle/Roboter/Abstandshalterungen(Horizontal)/Abstandshalterung oben (Linus).stl
90.0 x 28.0 x 10.0
