Kelimon/EntwklSchRob/3D Modelle/Roboter/Drehmechanismus/V3/Halterung Schrittmotor.stl

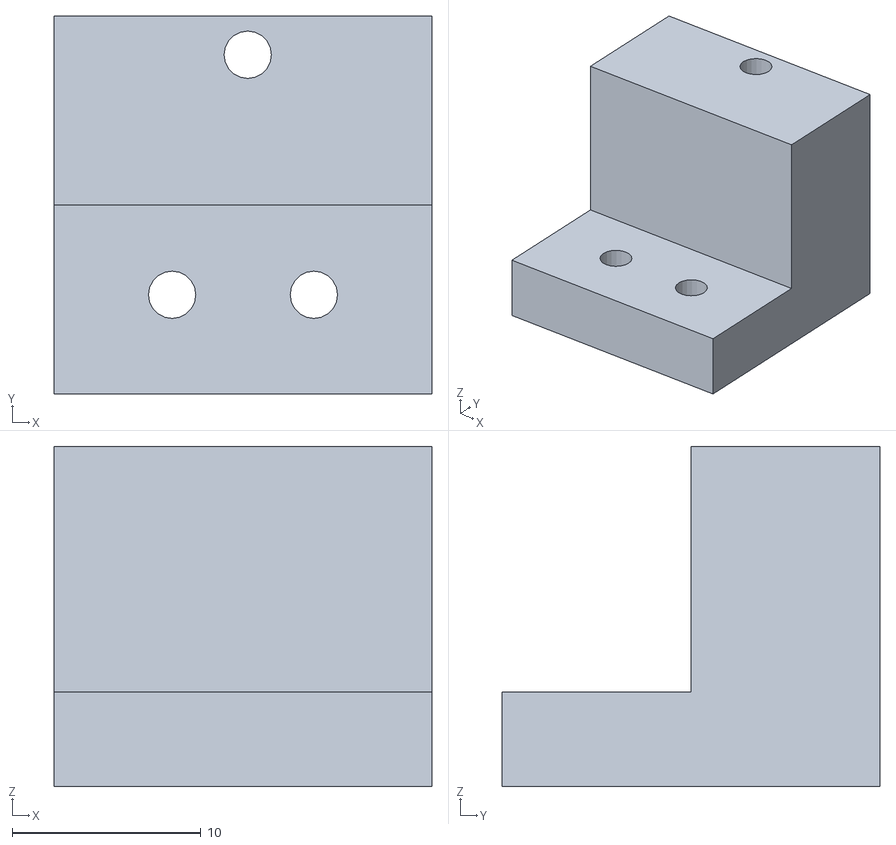
[picture p77: CAD file, 2024-02-26]
3D Modelle/Roboter/Drehmechanismus/V3/Halterung Schrittmotor.stl
20.0 x 20.0 x 18.0
