Kelimon/EntwklSchRob/3D Modelle/Roboter/Drehmechanismus/Zahnrad mit Halterung.stl

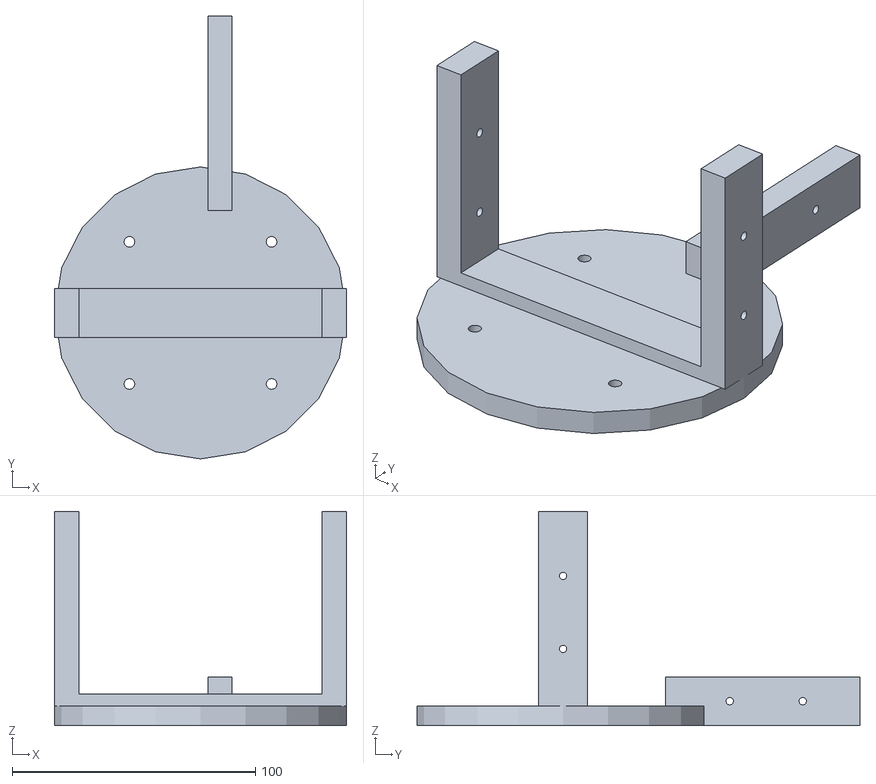
[picture p78: CAD file, 2024-02-01]
3D Modelle/Roboter/Drehmechanismus/Zahnrad mit Halterung.stl
120.0 x 182.0 x 88.0
