Kelimon/EntwklSchRob/3D Modelle/Roboter/Zweiter Linearmotor/Motor Halterung oben Lang.stl

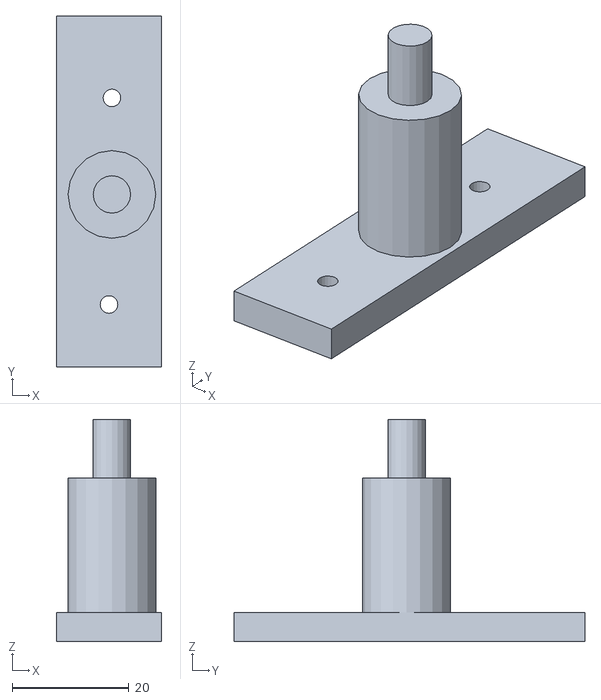
[picture p79: CAD file, 2023-12-07]
3D Modelle/Roboter/Zweiter Linearmotor/Motor Halterung oben Lang.stl
18.0 x 60.0 x 38.0
