Kelimon/EntwklSchRob/3D Modelle/Springer.stl

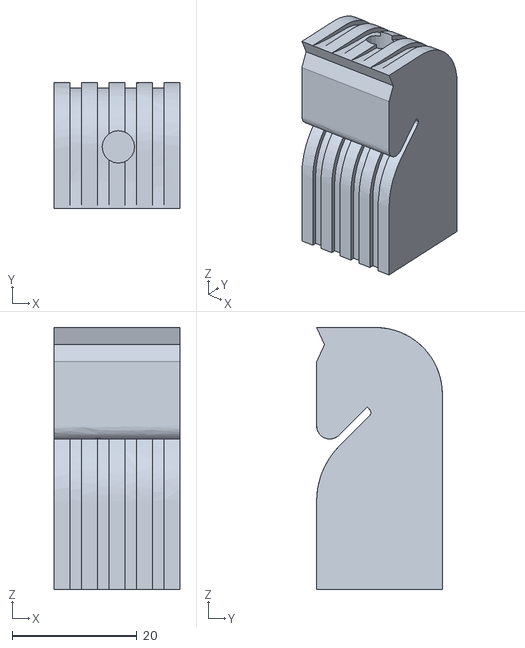
[picture p80: CAD file, 2024-06-05]
3D Modelle/Springer.stl
20.2 x 20.2 x 42.0
