Kelimon/EntwklSchRob/3D Modelle/Twisted_Hexagon_Chess_Set_680373/files/Hexagon_Chess_Board.DXF

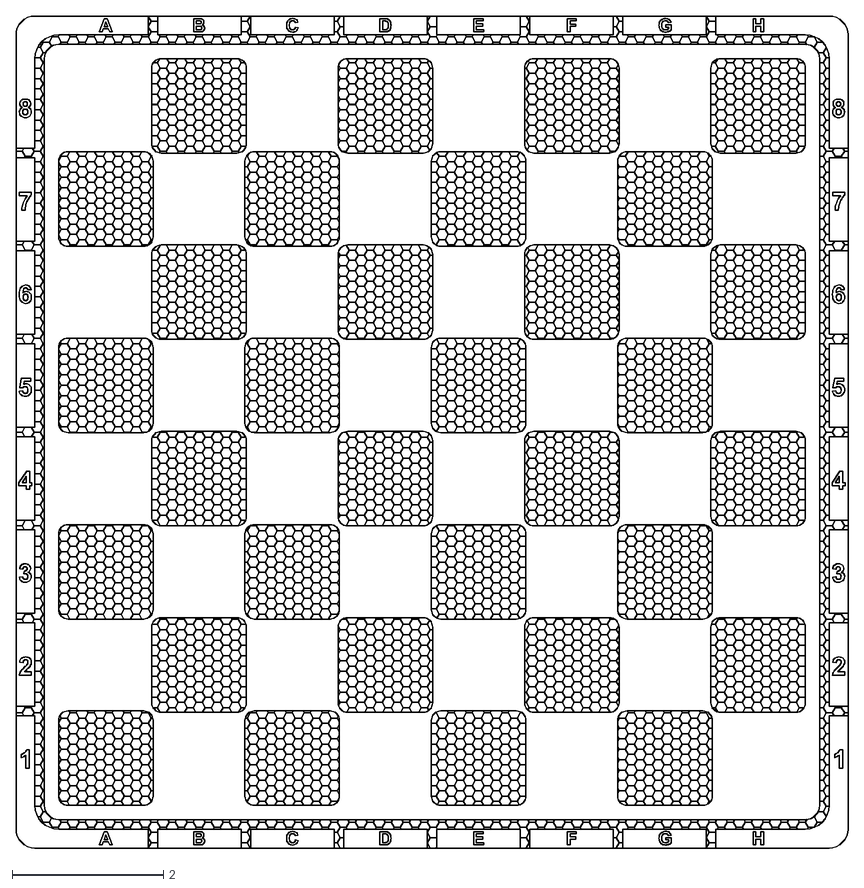
[picture p81: CAD file, 2023-10-30]
3D Modelle/Twisted_Hexagon_Chess_Set_680373/files/Hexagon_Chess_Board.DXF
11.0 x 11.0
