Kelimon/EntwklSchRob/3D Modelle/Dame.stl

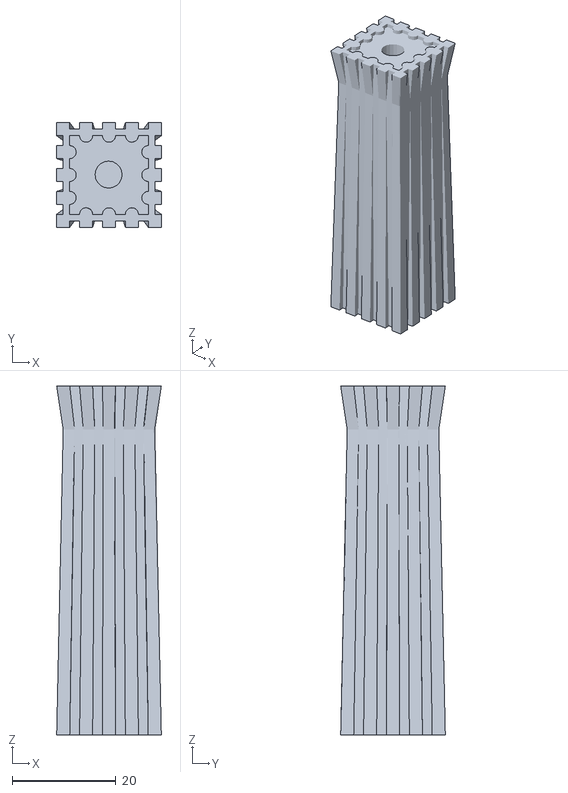
[picture p82: CAD file, 2024-06-05]
3D Modelle/Dame.stl
20.2 x 20.2 x 67.2
