Kelimon/EntwklSchRob/3D Modelle/pieces-d-echecs-minimalistes/05-Rook-V2.STL

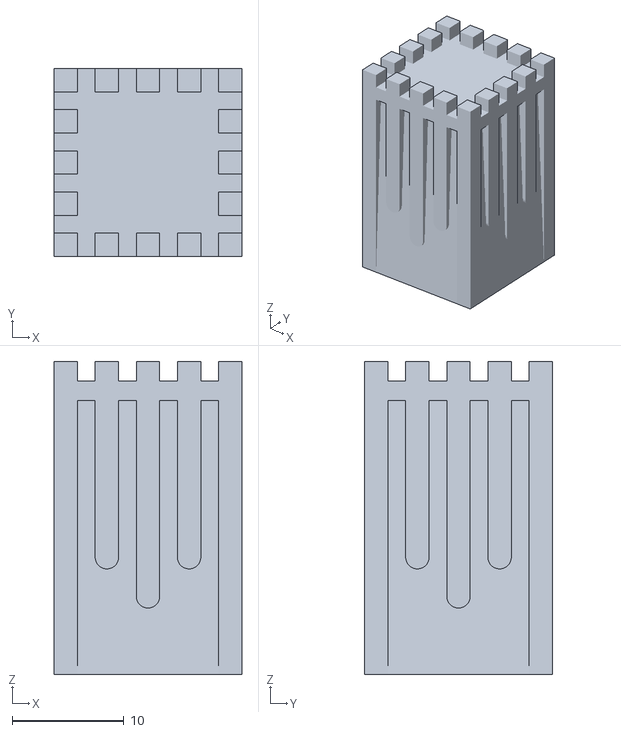
[picture p83: CAD file, 2023-10-30]
3D Modelle/pieces-d-echecs-minimalistes/05-Rook-V2.STL
16.8 x 16.8 x 28.0
