Kelimon/EntwklSchRob/3D Modelle/Roboter/Abstandshalterungen(Horizontal)/abstandshalter (Kurz).stl

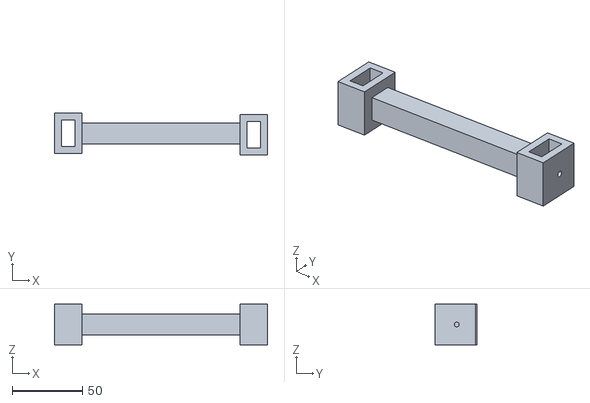
[picture p84: CAD file, 2023-11-29]
3D Modelle/Roboter/Abstandshalterungen(Horizontal)/abstandshalter (Kurz).stl
152.0 x 30.0 x 29.0
