Kelimon/EntwklSchRob/3D Modelle/Roboter/Drehmechanismus/V3/Zahnrad Schrittmotor mit passendem loch.stl

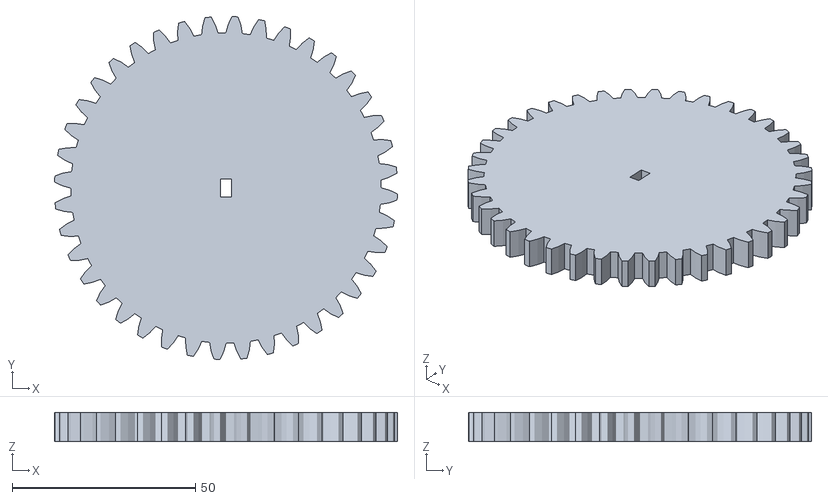
[picture p85: CAD file, 2024-02-25]
3D Modelle/Roboter/Drehmechanismus/V3/Zahnrad Schrittmotor mit passendem loch.stl
93.5 x 93.5 x 8.00
