Kelimon/EntwklSchRob/3D Modelle/Roboter/Erster Linearmotor/Motor Halterung unten.stl

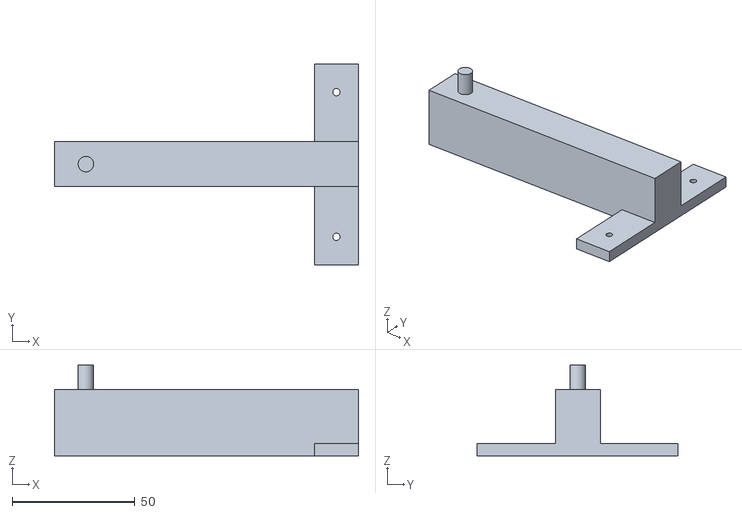
[picture p86: CAD file, 2023-11-29]
3D Modelle/Roboter/Erster Linearmotor/Motor Halterung unten.stl
124.0 x 82.0 x 37.0
