Kelimon/EntwklSchRob/3D Modelle/König.stl

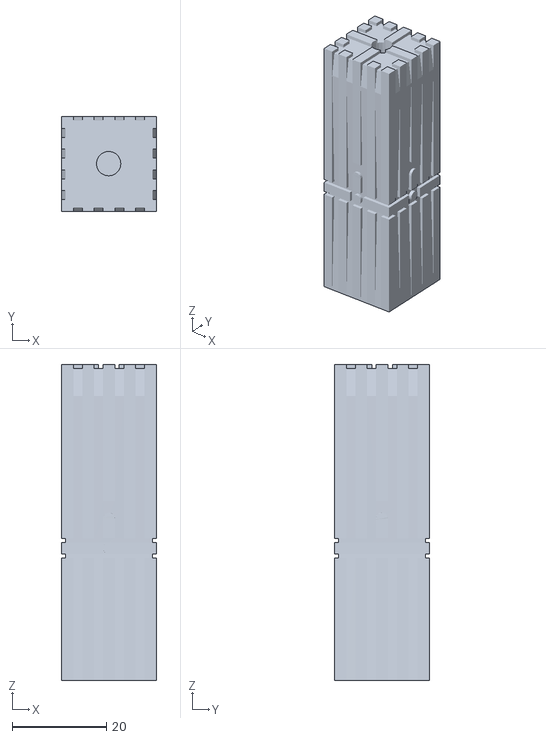
[picture p88: CAD file, 2024-06-05]
3D Modelle/König.stl
20.2 x 20.2 x 67.2
