Kelimon/EntwklSchRob/3D Modelle/pieces-d-echecs-minimalistes/01-King-V2.STL

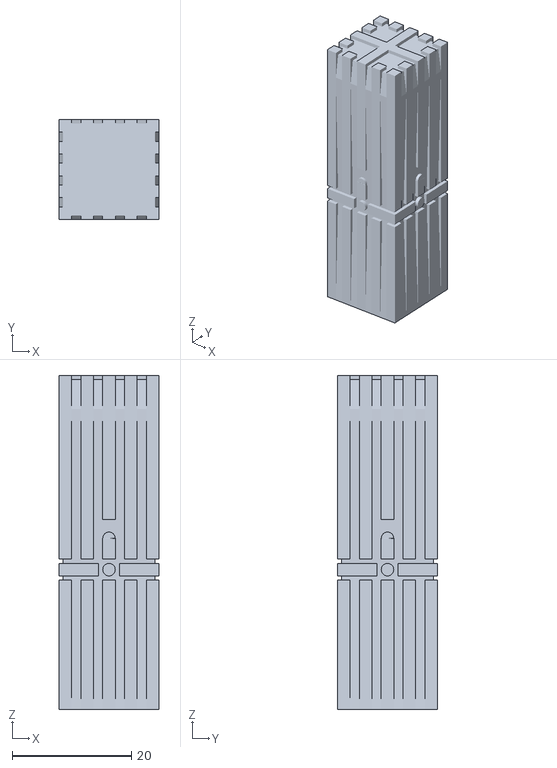
[picture p89: CAD file, 2023-10-30]
3D Modelle/pieces-d-echecs-minimalistes/01-King-V2.STL
16.8 x 16.8 x 56.0
