Kelimon/EntwklSchRob/3D Modelle/Roboter/Erster Linearmotor/Linearmotor Halterung oben.stl

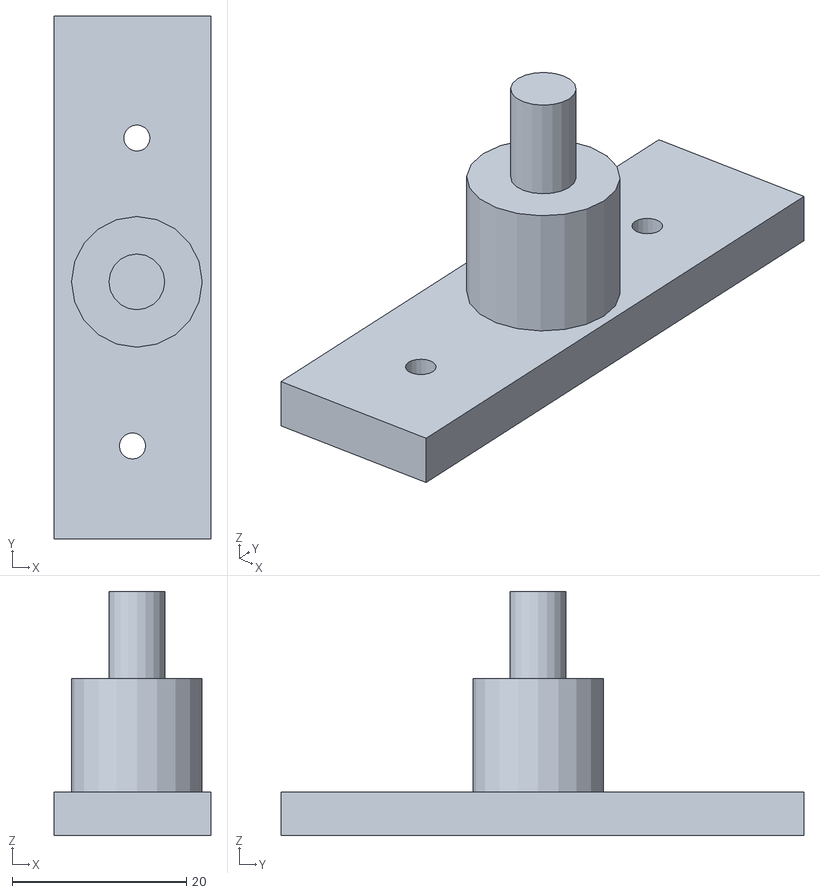
[picture p90: CAD file, 2023-11-29]
3D Modelle/Roboter/Erster Linearmotor/Linearmotor Halterung oben.stl
18.0 x 60.0 x 28.0
