Kelimon/EntwklSchRob/3D Modelle/Twisted_Hexagon_Chess_Set_680373/files/Twisted_Queen.STL

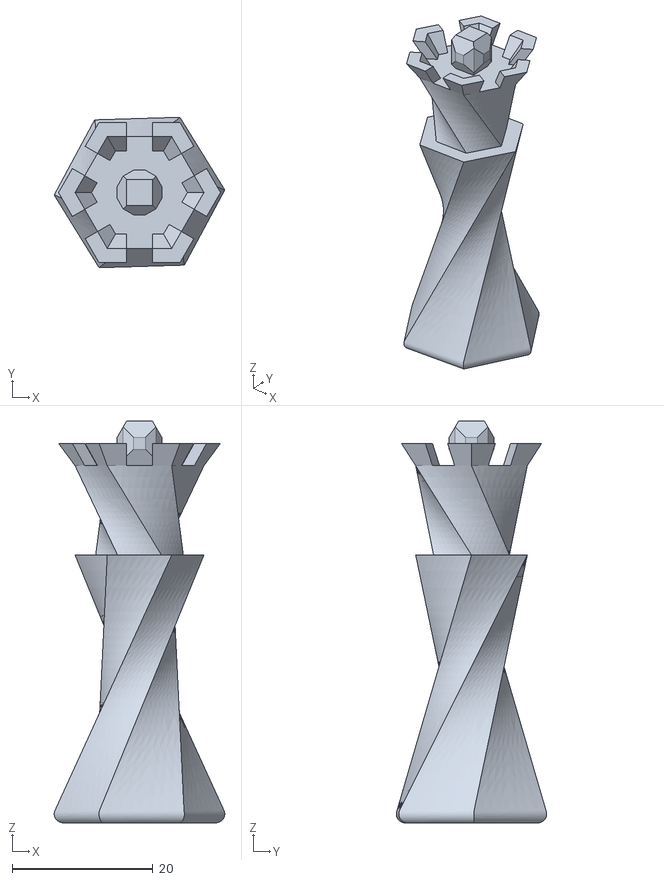
[picture p91: CAD file, 2023-10-30]
3D Modelle/Twisted_Hexagon_Chess_Set_680373/files/Twisted_Queen.STL
24.3 x 21.4 x 57.1
