Kelimon/EntwklSchRob/3D Modelle/8 Bauern.stl

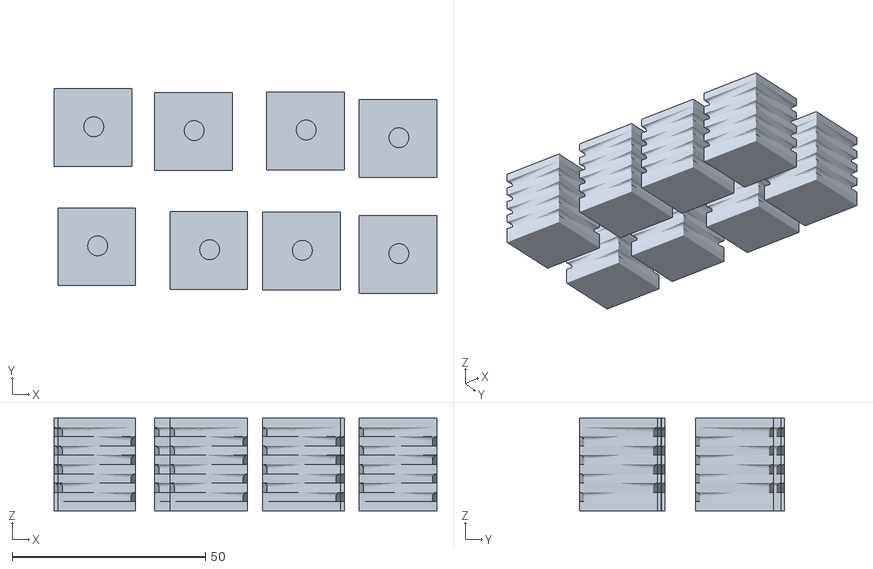
[picture p92: CAD file, 2024-06-01]
3D Modelle/8 Bauern.stl
99.2 x 53.0 x 24.0
