Kelimon/EntwklSchRob/3D Modelle/pieces-d-echecs-minimalistes/06-Pawn-V2.stl

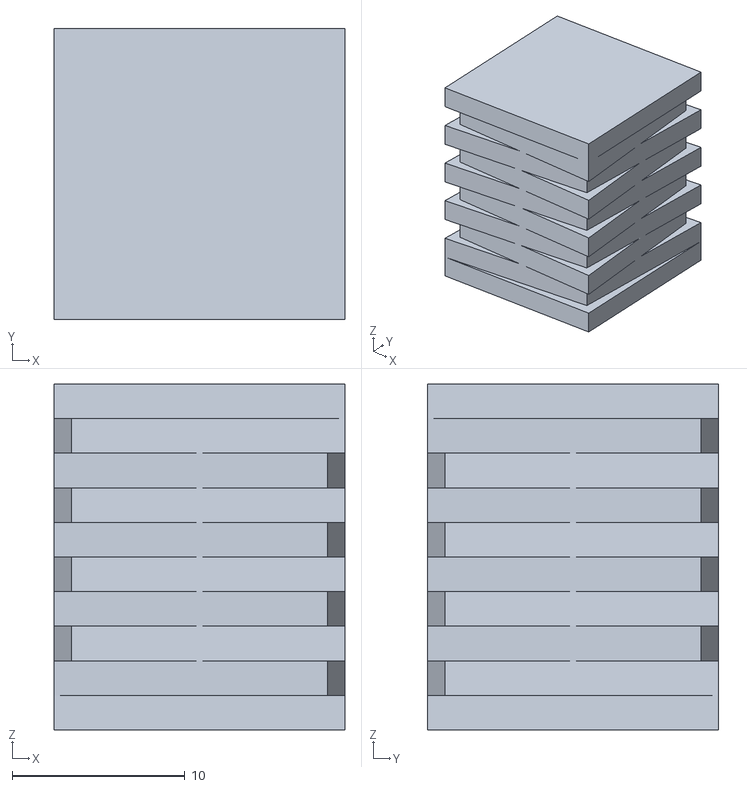
[picture p93: CAD file, 2023-10-30]
3D Modelle/pieces-d-echecs-minimalistes/06-Pawn-V2.stl
16.8 x 16.8 x 20.0
