Kelimon/EntwklSchRob/3D Modelle/Roboter/Linearmotor hochrunter/Halterung Magent.stl

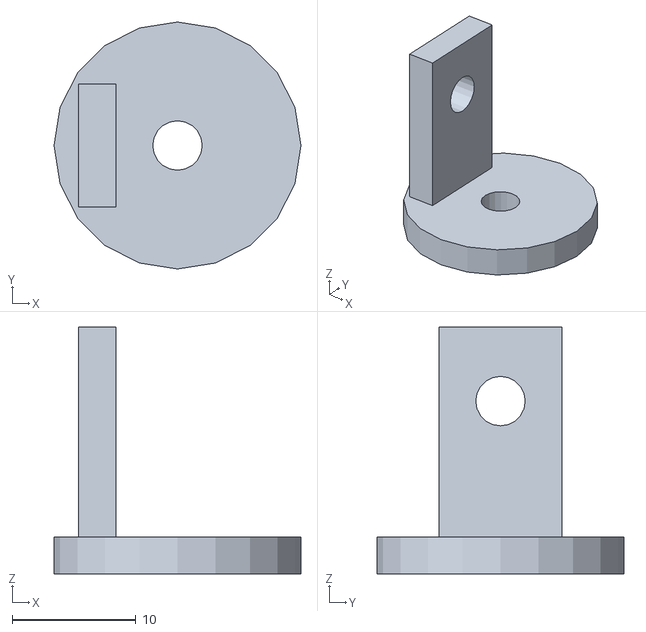
[picture p94: CAD file, 2024-05-07]
3D Modelle/Roboter/Linearmotor hochrunter/Halterung Magent.stl
20.0 x 20.0 x 20.0
