Kelimon/EntwklSchRob/3D Modelle/Twisted_Hexagon_Chess_Set_680373/files/Twisted_Pawn.STL

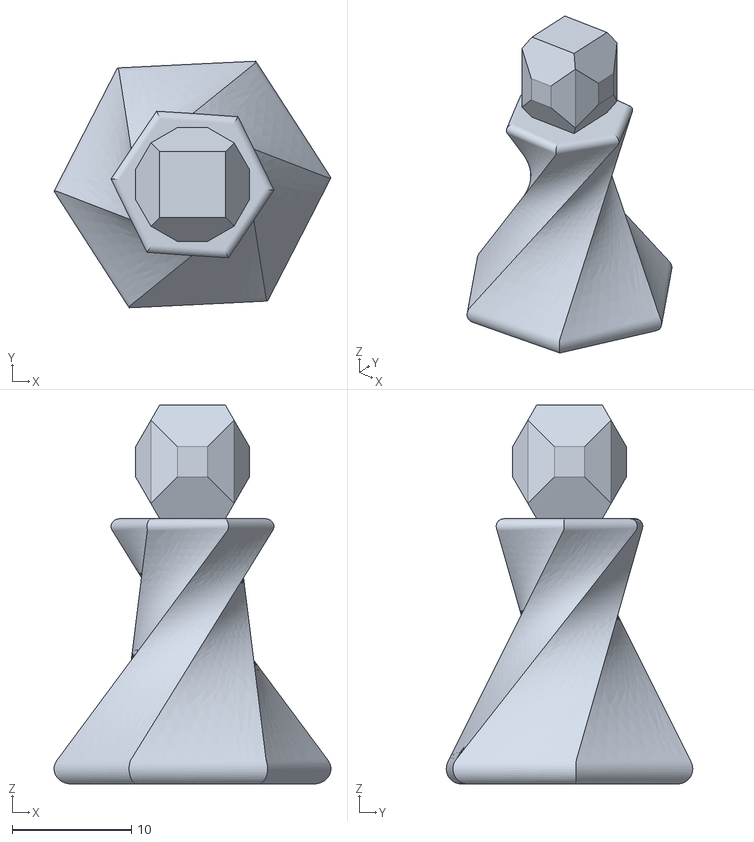
[picture p95: CAD file, 2023-10-30]
3D Modelle/Twisted_Hexagon_Chess_Set_680373/files/Twisted_Pawn.STL
23.2 x 20.7 x 31.8
