Kelimon/EntwklSchRob/3D Modelle/Figuren alle ohne Bauern.stl

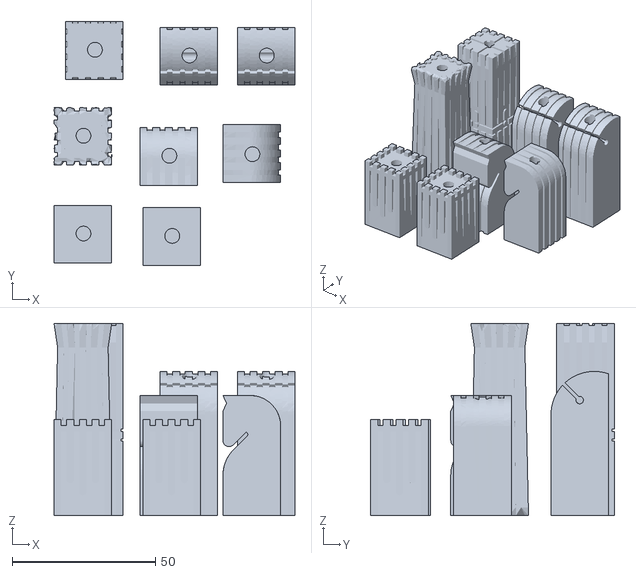
[picture p96: CAD file, 2024-06-01]
3D Modelle/Figuren alle ohne Bauern.stl
84.2 x 85.2 x 67.2
