Kelimon/EntwklSchRob/3D Modelle/Twisted_Hexagon_Chess_Set_680373/files/Twisted_Bishop.STL

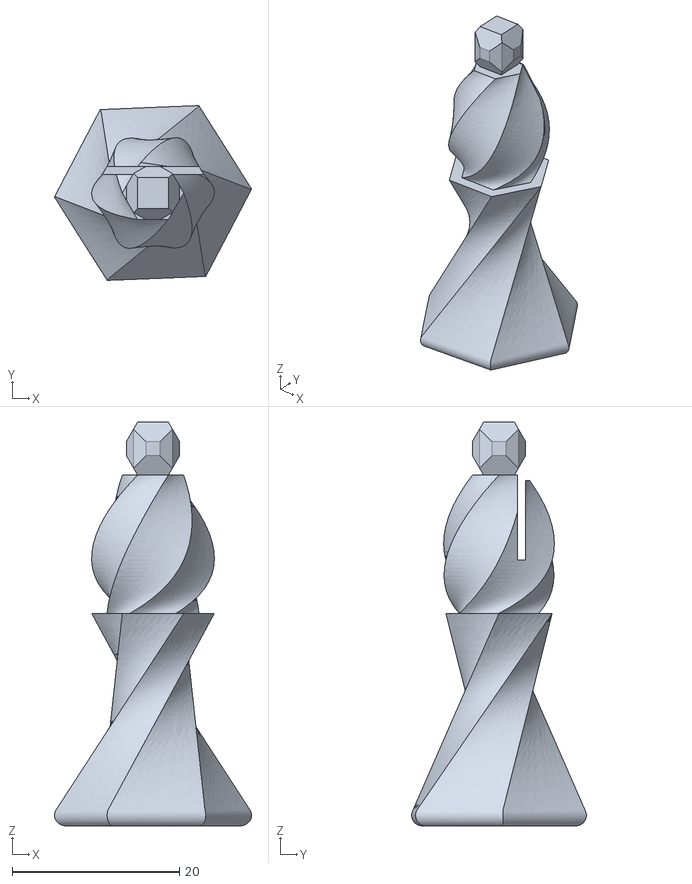
[picture p98: CAD file, 2023-10-30]
3D Modelle/Twisted_Hexagon_Chess_Set_680373/files/Twisted_Bishop.STL
23.6 x 20.9 x 48.3
