Kelimon/EntwklSchRob/3D Modelle/pieces-d-echecs-minimalistes/03-Bishop-V2.STL

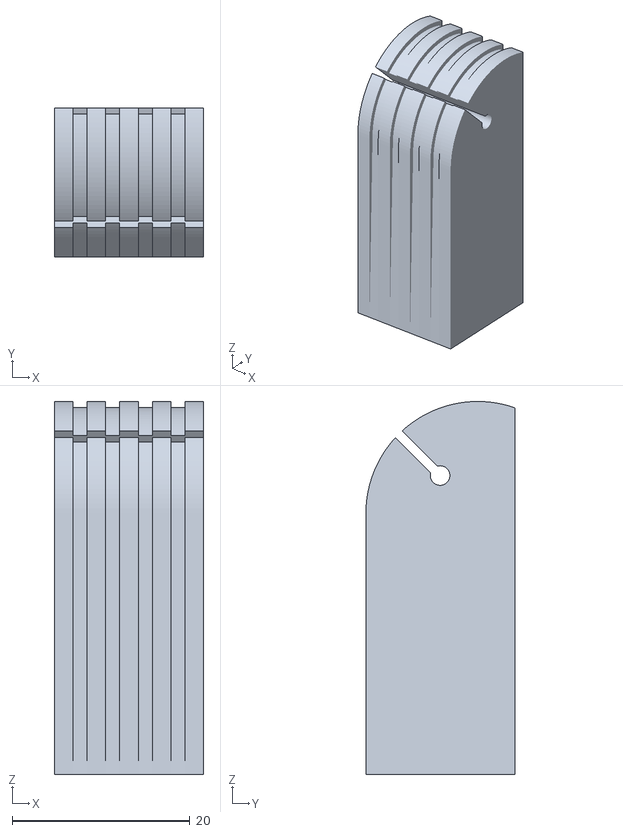
[picture p99: CAD file, 2023-10-30]
3D Modelle/pieces-d-echecs-minimalistes/03-Bishop-V2.STL
16.8 x 16.8 x 42.0
