Kelimon/EntwklSchRob/3D Modelle/Roboter/Linearmotor hochrunter/Halterung Linearmeotor klein.stl

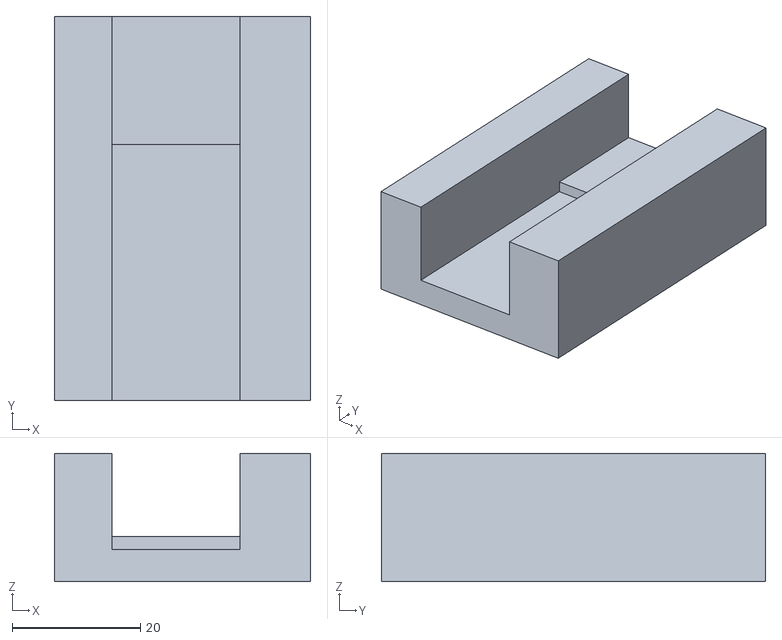
[picture p100: CAD file, 2024-05-07]
3D Modelle/Roboter/Linearmotor hochrunter/Halterung Linearmeotor klein.stl
40.0 x 60.0 x 20.0
