Kelimon/EntwklSchRob/(list of files, cad)

Other CAD files:
3D Modelle/Roboter/Zweiter Linearmotor/Motor Halterung oben Kurz Links.stl
3D Modelle/Roboter/Erster Linearmotor/Fantastic Bojo-Wolt(2).stl
3D Modelle/Roboter/Linearmotor hochrunter/Halterung Linearmotor Hoch runter.stl
3D Modelle/Roboter/Linearmotor hochrunter/Halterung Lkleiner Linearmotor v4.stl
3D Modelle/Roboter/Zweiter Linearmotor/Motor Halterung oben Kurz rechts.stl
3D Modelle/Roboter/Drehmechanismus/V3/Zahnrad Schrittmotor.stl
3D Modelle/Roboter/Linearmotor hochrunter/Halterung kleiner Linearmotor v3.stl
3D Modelle/Roboter/Linearmotor hochrunter/Halterung Magnbet.obj
