Kelimon/EntwklSchRob/(threads)

Thread 1 (2024-02-23):

Erkennung der Figuren

Gitarrenprofi, 2024-02-23:
Erkennung der Figuren ist zu Ungenau. Siehe Termin mit Noe iam 09.02.24
Alternativen Betrachten und bis zum nächsten Termin eine Lösung vorbereiten.

Kelimon, 2024-02-28:
Erkennung der Figuren verbessert und Noe vorgestellt am 28.02.2024. Intensiveres testen folgt um Quote der Erkennung zu ermitteln. Nächster Zwischenstand wird Noe am 25.02.2024 um 10 uhr vorgestellt.

Thread 3 (2024-02-23):

Ausarbeitung

Gitarrenprofi, 2024-02-23:
Wir haben noch nichts für die Ausarbeitung geschrieben!

Gitarrenprofi, 2024-02-25:
Ich habe des Dokument aufgesetzt. Ich habe Kommentare eingefügt welchen Teil ich übernehmen könnte. Passt das für dich?
