Kelimon/EntwklSchRob/Arduino Code/Test Drehmechanismus Server/servotest/servotest.ino

#include <Stepper.h> // Hinzufügen der Programmbibliothek.
int SPU = 2048; // Schritte pro Umdrehung.
Stepper Motor(SPU, 3,5,4,6); // Der Schrittmotor erhält die Bezeichnung "Motor" und es wird angegeben an welchen Pins der Motor angeschlossen ist.

void setup() //Hier beginnt das Setup.
{
Motor.setSpeed(3); // Angabe der Geschwindigkeit in Umdrehungen pro Minute.
}

void loop() {
Motor.step(1048); // Der Motor macht 2048 Schritte, das entspricht einer Umdrehung.

Motor.step(-1048); // Der Motor macht durch das Minuszeichen 2048 Schritte in die andere Richtung.

}
