Kelimon/EntwklSchRob/(commit log)

2023-10-12 added ausgefülltes GanttDiagramm
    [GanttDiagramm.xlsx]
2024-01-07 gant diagramm Prozent der Aufgaben aktualisiert
    [GanttDiagramm.xlsx]
2024-01-07 dispopaper added, excell renamed
    [Schachroboter_Zeitplan.xlsx]
2024-02-09 Zeitplan updated
    [Schachroboter_Zeitplan.xlsx]
2024-02-13 Create Winkel Drehung.stl
    [Winkel Drehung.stl]
2024-02-23 Drehmechanismus V3
    Um den Drehbereich des Roboters zu verbessern habe ich eine 3. Version des Drehmechanismus entwickelt. Hierfür habe ich auch einen Schrittmotor Bestellt.
    [Zahnrad Schrittmotor.stl, Zahnrad mit Halterung V3.stl]
2024-02-23 Gliederung Studienarbeit
    Ich habe mal ein Dokument für die Studienarbeit hier aufgesetzt und eine Gliederung mit Kommentaren geschrieben. Bitte lies dir die Kommentare durch und beantworte Sie.
2024-02-25 Update Drehmechanismus V3
    Ich habe die Zahnräder für den neuen Drehmechanismus ausgedruckt. Ich habe dir ein Bild in den Ordner gelegt. Außerdem müsste ich den ganzen Arm um 2c,m höher setzen. Ich werde hier einfach ein Brett nehmen. Ansonsten passt der Schrittmotor nicht rauf.
    Zusätzlich habe ich noch 2 Halterungen für den Schrittmotor erzeugt und drucke diese gerade (In Sogar nur 34min ;).
    Ansonsten bin ich gespannt was du geschafft hast. Update mich gerne mal
    [Halterung Schrittmotor.stl, Zahnrad Schrittmotor mit passendem loch.stl]
2024-02-26 Projektarbeit schreiben
    ich habe einige Kapitel in der Projektarbeit geschrieben. Bitte mach du da auch etwas. Zusätzlich habe ich einen Fehler in dem 3D Modell für den neuen Dehmechanismus korrigiert.
    [Halterung Schrittmotor.stl, Schachroboter_Zeitplan.xlsx]
2024-02-26 Drehmechanismus V3 Funktionstests
    Ich habe den Drehmechanismus V3 zusammengebaut und den Server verkabelt. Funktioniert alles ich bin mir nur noch net sicher ob der Mechanismus stark genug ist. Ich kann in mit meiner Hand realtiv leicht anhalten
2024-02-27 Update Studienarbeit
    3D Druck verfahren und 3D Druck Materialen geschrieben
2024-02-28 Treffen mit Noe 28.02.2024
    Notizen. Update des Zeitplans. Termine für neue Absprachetrefffen
    [Schachroboter_Zeitplan.xlsx]
2024-03-11 Update Zahnrad mit Halterung V3.stl
    Verbesserung der Halterung
    [Zahnrad mit Halterung V3.stl]
2024-04-12 Create Halterung Linearmeotor klein.stl
    [Halterung Linearmeotor klein.stl]
2024-04-15 Halterung Linearmotor hochrunter
    [Halterung Linearmotor v2.stl, Halterung Magent.stl, Halterung Magnbet.obj]
2024-04-16 Upgrade Linearmotor klein
    [Halterung Linearmotor Hoch runter.stl, Halterung kleiner Linearmotor v3.stl]
2024-04-16 Halterung Linearmotor v4
    [Halterung Lkleiner Linearmotor v4.stl]
2024-06-05 arduino main added, tinker added
